bouLED/bouled/README.md

# bouLED

For more information, head over to [the blog](https://rose.telecom-paristech.fr/2019/bouled)
and to [hackaday.io](https://hackaday.io/project/168026-bouled).

The 3D design is made with OpenSCAD and SolveSpace. However, for PCB design,
Xpedition PCB was used (but PDF renders are available).

# License

This project, except the docs/ folder, is under the [GPLv3 license](LICENSE.md).

Copyright (c) 2018 Lucas Lebailly, Hichem Ghandri, Matthias Rabault
