bouLED/bouled/design/LED_Panel/README.md

The mounting holes are placed on the triangle's medians, the height of the lowest two being arbitrarily set to y=12mm.
See place_holes.py.
