bouLED/bouled/3dstructure/corner/README.md

# Corners

`corner.slvs` is a piece that links five triangles at their common corner. It's
made using `corner_element.slvs`, which is one fifth of the corner.

Only `corner.slvs` is meant to be 3D printed. These were made using SolveSpace
2.3.
