bouLED/bouled/3dstructure/prototype_triangle/README.md

# Prototype triangles

These were early experiments in triangle design, made to fit commercially
available APA102 strips in them to learn how to control them.
