bouLED/bouled/firmwares/mainboard/README.md

# Main board

This is the main board's firmware.

# Running

`make startgdbserver` starts the J-Link GDB Server. Then, in another terminal, run
`make debug` to compile, open GDB and flash the board.

# TODO
SPI1 MOSI GPIO speed
