bouLED/bouled/design/LED_Panel/Integration/AugmentedPins.txt

------------------------------------------------------------------------
            Part/Reference             | Pin | Augmented Net Name
------------------------------------------------------------------------
