bouLED/bouled/design/main_board/routing_STM32H743VIT6.ods

Sheet: Feuille1
STM32H743VIT6 (LQFP100)
 |  |  |  |  | AF0 | AF1 | AF2 | AF3 | AF4 | AF5 | AF6 | AF7 | AF8 | AF9 | AF10 | AF11 | AF12 | AF13 | AF14 | AF15
Pin | Connection | Pin name | I / O | 5V | SYS | TIM1/2/16/17 / LPTIM1/ HRTIM1 | SAI1 / TIM3/4/5/12 / HRTIM1 | LPUART / TIM8 / LPTIM2/3/4/5 / HRTIM1 / DFSDM | I2C1/2/3/4 / USART1 / TIM15 / LPTIM2 / DFSDM / CEC | SPI1/2/3/4/5/6 / CEC | SPI2/3 / SAI1/3 / I2C4 / UART4 / DFSDM | SPI2/3/6 / USART1/2/3/6 / UART7 / SDMMC1 | SPI6 / SAI2/4 / UART4/5/8 / LPUART / SDMMC1 / SPDIFRX | SAI4 / FDCAN1/2/ TIM13/14 / QUADSPI / FMC / SDMMC2 / LCD / SPDIFRX | SAI2/4 / TIM8 / QUADSPI / SDMMC2 / OTG1_HS / OTG2_FS / LCD | I2C4 / UART7 / SWPMI1 / TIM1/8 / DFSDM / SDMMC2 / MDIOS / ETH | TIM1/8 / FMC / SDMMC1 / MDIOS / OTG1_FS / LCD | TIM1 / DCMI / LCD / COMP | UART5 / LCD | SYS | Additionnal functions
1 | ESP_SPI_SCK | PE2 | I/O | FT_h | TRACECLK |  | SAI1_CK1 |  |  | SPI4_SCK | SAI1_MCLK_A |  | SAI4_MCLK_A | QUADSPI_BK1_IO2 | SAI4_CK1 | ETH_MII_TXD3 | FMC_A23 |  |  | EVENT OUT
2 | ESP_SPI_HS | PE3 | IRQ | FT_h | TRACED0 |  |  |  | TIM15_BKIN |  | SAI1_SD_B |  | SAI4_SD_B |  |  |  | FMC_A19 |  |  | EVENT OUT
3 | ESP_SPI_NSS | PE4 | I/O | FT_h | TRACED1 |  | SAI1_D2 | DFSDM_DATIN3 | TIM15_CH1N | SPI4_NSS | SA1_FS_A |  | SAI4_FS_A |  | SAI4_D2 |  | FMC_A20 | DCMI_D4 | LCD_B0 | EVENT OUT
4 | ESP_SPI_MISO | PE5 | I/O | FT_h | TRACED2 |  | SAI1_CK2 | DFSDM_CKIN3 | TIM15_CH1 | SPI4_MISO | SAI1_SCK_A |  | SAI4_SCK_A |  | SAI4_CK2 |  | FMC_A21 | DCMI_D6 | LCD_G0 | EVENT OUT
5 | ESP_SPI_MOSI | PE6 | I/O | FT_h | TRACED3 | TIM1_BKIN2 | SAI1_D1 |  | TIM15_CH2 | SPI4_MOSI | SA1_SD_A |  | SAI4_SD_A | SAI4_D1 | SAI2_MCK_B | TIM2_BKIN2_COMP12 | FMC_A22 | DCMI_D7 | LCD_G1 | EVENT OUT
6 |  | VBAT | S | __
7 |  | PC13 | I/O | FT |  |  |  |  |  |  |  |  |  |  |  |  |  |  |  | EVENT OUT
8 |  | PC14 / OSC32_IN | I/O | FT |  |  |  |  |  |  |  |  |  |  |  |  |  |  |  | EVENT OUT
9 |  | PC15 / OSC32_OUT | I/O | FT |  |  |  |  |  |  |  |  |  |  |  |  |  |  |  | EVENT OUT
10 |  | VSS | S | __
11 |  | VDD | S | __
12 | OSC_IN | PH0 / OSC_IN | I/O | FT |  |  |  |  |  |  |  |  |  |  |  |  |  |  |  | EVENT OUT
13 | OSC_OUT | PH1 / OSC_OUT | I/O | FT |  |  |  |  |  |  |  |  |  |  |  |  |  |  |  | EVENT OUT
14 |  | NRST | I/O | RST
15 |  | PC0 | I/O | FT_a |  |  |  | DFSDM_CKIN0 |  |  | DFSDM_DATIN4 |  | SAI2_FS_B |  | OTG_HS_ULPI_STP |  | FMC_SDNWE |  | LCD_R5 | EVENT OUT
16 | SPI2_MOSI | PC1 | I/O | FT_ha | TRACED0 |  | SAI1_D1 | DFSDM_DATAIN0 | DFSDM_CKIN4 | SPI2_MOSI / I2S2_SDO | SAI1_SD_A |  | SAI4_SD_A | SDMMC2_CK | SAI4_D1 | ETH_MDC | MDIOS_MDC |  |  | EVENT OUT
17 |  | PC2_C | I/O | TT_a |  |  |  | DFSDM_CKIN1 |  | SPI2_MISO / I2S2_SDI | DFSDM_CKOUT |  |  |  | OTG_HS_ULPI_DIR | ETH_MII_TXD2 | FMC_SDNE0 |  |  | EVENT OUT
18 |  | PC3_C | I/O | TT_a |  |  |  | DFSDM_DATAIN1 |  | SPI2_MOSI / I2S2_SDO |  |  |  |  | OTG_HS_ULPI_NXT | ETH_MII_TX_CLK | FMC_SDCKE0 |  |  | EVENT OUT
19 |  | VSSA | S | __
20 |  | VREF+ | S | __
21 |  | VDDA | S | __
22 | STM_2_ESP | PA0 | I/O | FT_a |  | TIM2_CH1 / TIM2_ETR | TIM5_CH1 | TIM8_ETR | TIM15_BKIN |  |  | USART2_CTS | UART4_TX | SDMMC2_CMD | SAI2_SD_B | ETH_MII_CRS |  |  |  | EVENT OUT
23 | ESP_2_STM | PA1 | I/O | FT_ha |  | TIM2_CH2 | TIM5_CH2 | LPTIM4_OUT | TIM15_CH1N |  |  | USART2_RTS | UART4_RX | QUADSPI_BK1_IO3 | SAI2_MCK_B | ETH_MII_RX_CLK / ETH_RMII_REF_CLK |  |  | LCD_R2 | EVENT OUT
24 |  | PA2 | I/O | FT_a |  | TIM2_CH3 | TIM5_CH3 | LPTIM4_OUT | TIM15_CH1 |  |  | USART2_TX | SAI2_SCK_B |  |  | ETH_MDIO | MDIOS_MDIO |  | LCD_R1 | EVENT OUT
25 |  | PA3 | I/O | FT_ha |  | TIM2_CH4 | TIM5_CH4 | LPTIM5_OUT | TIM15_CH2 |  |  | USART2_RX |  | LCD_B2 | OTG_HS_ULPI_D0 | ETH_MII_COL |  |  | LCD_B5 | EVENT OUT
26 |  | VSS | S | __
27 |  | VDD | S | __
28 |  | PA4 | I/O | TT_a |  |  | TIM5_ETR |  |  | SPI1_NSS / IS21_WS | SPI3_NSS / I2S3_WS | USART2_CK | SPI6_NSS |  |  |  | OTG_HS_SOF | DCMI_HSYNC | LCD_VSYNC | EVENT OUT
29 | SPI1_SCK | PA5 | I/O | TT_ha |  | TIM2_CH1 / TIM2_ETR |  | TIM8_CH1N |  | SPI1_SCK / I2S1_CK |  |  | SPI6_SCK |  | OTG_HS_ULPI_CK |  |  |  | LCD_R4 | EVENT OUT
30 |  | PA6 | I/O | FT_a |  | TIM1_BKIN | TIM3_CH1 | TIM8_BKIN |  | SPI1_MISO / I2S1_SDI |  |  | SPI6_MISO | TIM13_CH1 | TIM8_BKIN_COMP12 | MDIOS_MDC | TIM1_BKIN_COMP12 | DCMI_PIXCLK | LCD_G2 | EVENT OUT
31 | SPI1_MOSI | PA7 | I/O | TT_a |  | TIM1_CH1N | TIM3_CH2 | TIM8_CH1N |  | SPI1_MOSI / I2S1_SDO |  |  | SPI6_MOSI | TIM14_CH1 |  | ETH_MII_RDX_DV /ETH_RMII_CRS_DV | FMC_SDNWE |  |  | EVENT OUT
32 |  | PC4 | I/O | TT_a |  |  |  | DFSDM_CKIN2 |  | I2S1_MCK |  |  |  | SPDIF_RX_IN2 |  | ETH_MII_RXD0 /ETH_RMII_RXD0 | FMC_SDNE0 |  |  | EVENT OUT
33 |  | PC5 | I/O | TT_a |  |  | SAI1_D3 | DFSDM_DATAIN2 |  |  |  |  |  | SPDIF_RX_IN3 | SAI4_D3 | ETH_MII_RXD1 /ETH_RMII_RXD0 | FMC_SDCKE0 | COMP1_OUT |  | EVENT OUT
34 |  | PB0 | I/O | FT_a |  | TIM1_CH2N | TIM3_CH3 | TIM8_CH2N |  |  | DFSDM1_CKOUT |  | UART4_CTS | LCD_R3 | OTG_HS_ULPI_D1 | ETH_MII_RXD2 |  |  | LCD_G1 | EVENT OUT
35 |  | PB1 | I/O | TT_u |  | TIM1_CH3N | TIM3_CH4 | TIM8_CH3N |  |  | DFSDM1_DATIN1 |  |  | LCD_R6 | OTG_HS_ULPI_D2 | ETH_MII_RXD3 |  |  | LCD_G0 | EVENT OUT
36 |  | PB2 | I/O | FT_ha |  |  | SAI1_D1 |  | DFSDM_CKIN |  | SAI1_SD_A | SPI3_MOSI /I2S3_SDO | SAI4_SDA | QUADSPI_CLK | SAI4_D1 |  |  |  |  | EVENT OUT
37 |  | PE7 | I/O | TT_ha |  | TIM1_ETR |  | DFSDM_DATIN2 |  |  |  | UART7_RX |  |  | QUADSPI_BK2_IO0 |  | FMC_D4 / FMC_DA4 |  |  | EVENT OUT
38 |  | PE8 | I/O | TT_ha |  | TIM1_CH1N |  | DFSDM_CKIN2 |  |  |  | UART7_TX |  |  | QUADSPI_BK2_IO1 |  | FMC_D5 / FMC_DA5 | COMP2_OUT |  | EVENT OUT
39 |  | PE9 | I/O | TT_ha |  | TIM1_CH1 |  | DFSDM_CKOUT |  |  |  | UART7_RTS |  |  | QUADSPI_BK2_IO2 |  | FMC_D6 / FMC_DA6 |  |  | EVENT OUT
40 |  | PE10 | I/O | FT_ha |  | TIM1_CH2N |  | DFSDM_DATIN4 |  |  |  | UART7_CTS |  |  | QUADSPI_BK2_IO3 |  | FMC_D7 / FMC_DA7 |  |  | EVENT OUT
41 |  | PE11 | I/O | FT_ha |  | TIM1_CH2 |  | DFSDM_CKIN4 |  | SPI4_NSS |  |  |  |  | SAI2_SD_B |  | FMC_D8 / FMC_DA8 |  | LCD_G3 | EVENT OUT
42 |  | PE12 | I/O | FT_h |  | TIM1_CH3N |  | DFSDM_DATIN5 |  | SPI4_SCK |  |  |  |  | SAI2_SCK_B |  | FMC_D9 / FMC_DA9 | COMP_1_OUT | LCD_B4 | EVENT OUT
43 |  | PE13 | I/O | FT_h |  | TIM1_CH3 |  | DFSDM_CKIN5 |  | SPI4_MISO |  |  |  |  | SAI2_FS_B |  | FMC_D10 / FMC_DA10 | COMP_2_OUT | LCD_DE | EVENT OUT
44 |  | PE14 | I/O | FT_h |  | TIM1_CH4 |  |  |  | SPI4_MOSI |  |  |  |  | SAI2_MCK_B |  | FMC_D11 / FMC_DA11 |  | LCD_CLK | EVENT OUT
45 |  | PE15 | I/O | FT_h |  | TIM1_BKIN |  |  |  | HDMI_TIM1_BKIN |  |  |  |  |  |  | FMC_D12 / FMC_DA12 | TIM1_BKIN_COMP12 | LCD_R7 | EVENT OUT
46 | SPI2_SCK | PB10 | I/O | FT_f |  | TIM2_CH3 | HRTIM_SCOUT | LPTIM2_IN1 | I2C2_SCL | SPI2_SCK / I2S2_CK | DFSDM1_DATIN7 | USART3_TX |  | QUADSPI_BK1_NCS | OTG_HS_ULPI_D3 | ETH_MII_RX_ER |  |  | LCD_G4 | EVENT OUT
47 |  | PB11 | I/O | FT_f |  | TIM2_CH4 | HRTIM_SCIN | LPTIM2_ETR | I2C2_SDA |  | DFSDMI_CKIN7 | USART3_RX |  |  | OTG_HS_ULPI_D4 | ETH_MII_TX_EN / ETH_RMII_TX_EN |  |  | LCD_G5 | EVENT OUT
48 |  | VCAP-1 | S | __
49 |  | VSS | S | __
50 |  | VDD | S | __
51 |  | PB12 | I/O | FT_u |  | TIM1_BKIN |  |  | I2C2_SMBA | SPI2_NSS / I2S2_WS | DFSDM1_DATIN1 | USART3_CK |  | FDCAN2_RX | OTG_HS_ULPI_D5 | ETH_MII_TXD0 / ETH_RMII_TXD0 | OTG_HS_ID | TIM1_BKIN_COMP12 | UART5_RX | EVENT OUT
52 |  | PB13 | I/O | FT_u |  | TIM1_CH1N |  | LPTIM2_OUT |  | SPI2_SCK / I2S2_SCK | DFSDM1_CKIN1 | USART3_CTS_NSS |  | FDCAN2_TX | OTG_HS_ULPI_D6 | ETH_MII_TXD1 / ETH_RMII_TXD1 |  |  | UART5_TX | EVENT OUT
53 | SDMMC2_D0 | PB14 | I/O | FT_u |  | TIM1_CH2N | TIM12_CH1 | TIM8_CH2N | USART1_TX | SPI2_MISO / I2S2_SDI | DFSDM1_DATIN2 | USART3_RTS | UART4_RTS | SDMMC2_D0 |  |  | OTG_HS_DM |  |  | EVENT OUT
54 |  | PB15 | I/O | FT_u | RTC_REFIN | TIM1_CH3N | TIM12_CH2 | TIM8_CH3N | USART1_RX | SPI2_MOSI / I2S2_SDO | DFSDM1_CKIN2 |  | UART4_CTS | SDMMC2_D1 |  |  | OTG_HS_DP |  |  | EVENT OUT
55 |  | PD8 | I/O | FT_h |  |  |  | DFSDM_CKIN3 |  |  | SAI3_SCK_B | USART3_TX |  | SPDIFRX_IN1 |  |  | FMC_D13 / FMC_DA13 |  |  | EVENT OUT
56 |  | PD9 | I/O | FT_h |  |  |  | DFSDM_DATAIN3 |  |  | SAI3_SD_B | USART3_RX |  | FDCAN2_RXFD_MODE |  |  | FMC_D14 / FMC_DA14 |  |  | EVENT OUT
57 |  | PD10 | I/O | FT_h |  |  |  | DFSDM_CKOUT |  |  | SAI3_FS_B | USART3_CK |  | FDCAN2_TXFD_MODE |  |  | FMC_D15 / FMC_DA15 |  | LCD_B3 | EVENT OUT
58 |  | PD11 | I/O | FT_h |  |  |  | LPTIM2_IN2 | I2C4_SMBA |  |  | USART3_CTS |  | QUADSPI_BK1_IO0 | SAI2_SD_A |  | FMC_A16 |  |  | EVENT OUT
59 | I2C_SCL | PD12 | I/O | FT_fh |  | LPTIM1_IN1 | TIM4_CH1 | LPTIM2_IN1 | I2C4_SCL |  |  | USART3_RTS |  | QUADSPI_BK1_IO1 | SAI2_FS_A |  | FMC_A17 |  |  | EVENT OUT
60 | I2C_SDA | PD13 | I/O | FT_fh |  | LPTIM1_OUT | TIM4_CH2 |  | I2C4_SDA |  |  |  |  | QUADSPI_BK1_IO3 | SAI2_SCK_A |  | FMC_A18 |  |  | EVENT OUT
61 |  | PD14 | I/O | FT_h |  |  | TIM4_CH3 |  |  |  | SAI3_MCLK_B |  | UART8_CTS |  |  |  | FMC_D0 / FMC_DA0 |  |  | EVENT OUT
62 |  | PD15 | I/O | FT_h |  |  | TIM4_CH4 |  |  |  | SAI3_MCLK_A |  | UART8_RTS |  |  |  | FMC_D1 / FMC_DA1 |  |  | EVENT OUT
63 |  | PC6 | I/O | FT_h |  | HRTIM_CHA1 | TIM3_CH1 | TIM8_CH1 | DFSDM_CKIN3 | I2S2_MCK |  | USART6_TX | SDMMC1_D0DIR | FMC_NWAIT | SDMMC2_D6 |  | SDMMC1_D6 | DCMI_D0 | LCD_HSYNC | EVENT OUT
64 |  | PC7 | I/O | FT_h | TRGIO | HRTIM_CHA2 | TIM3_CH2 | TIM8_CH2 | DFSDM_DATIN3 |  | I2S3_MCK | USART6_RX | SDMMC1_D123DIR | FMC_NE1 | SDMMC2_D7 | SWPMI_TX | SDMMC1_D7 | DCMI_D1 | LCD_G6 | EVENT OUT
65 |  | PC8 | I/O | FT_h | TRACED1 | HRTIM_CHB1 | TIM3_CH3 | TIM8_CH3 |  |  |  | USART6_CK | UART5_RTS | FMC_NE2 / FMC_NCE |  | SWPMI_RX | SDMMC1_D0 | DCMI_D2 |  | EVENT OUT
66 |  | PC9 | I/O | FT_fh | MCO2 |  | TIM3_CH4 | TIM8_CH4 | I2C3_SDA | I2S_CKIN |  |  | UART5_CTS | QUADSPI_BK1_IO0 | LCD_G3 | SWPMI_SUSPEND | SDMMC1_D1 | DCMI_D3 | LCD_B2 | EVENT OUT
67 | LED_R | PA8 | I/O | FT_fha | MCO1 | TIM1_CH1 | HRTIM_CHB2 | TIM8_BKIN2 | I2C3_SCL |  |  | USART1_CK |  |  | OTG_FS_SOF | UART7_RX | TIM8_BKIN2_COMP12 | LCD_B3 | LCD_R6 | EVENT OUT
68 | LED_G | PA9 | I/O | FT_u |  | TIM1_CH2 | HRTIM_CHC1 | LPUART1_TX | I2C3_SMBA | SPI2_SCK / I2S2_CK |  | USART1_TX |  | FDCAN1_RXFD_MODE |  |  |  | DCMI_D0 | LCD_R5 | EVENT OUT
69 | LED_B | PA10 | I/O | FT_u |  | TIM1_CH3 | HRTIM_CHC2 | LPUART1_RX |  |  |  | USART1_RX |  | FDCAN1_TXFD_MODE | OTG_FS_ID | MDIOS_MDIO | LCD_B4 | DCMI_D1 | LCD_B1 | EVENT OUT
70 |  | PA11 | I/O | FT_u |  | TIM1_CH4 | HRTIM_CHD1 | LPUART1_CTS |  | SPI2_NSS / I2S2_WS | UART4_RX | USART1_CTS |  | FDCAN1_RX | OTG_FS_DM |  |  |  | LCD_R4 | EVENT OUT
71 |  | PA12 | I/O | FT_u |  | TIM1_ETR | HRTIM_CHD2 | LPUART1_RTS |  | SPI2_SCK / I2S2_CK | UART4_TX | USART1_RTS | SAI2_FS_B | FDCAN1_TX | OTG_FS_DP |  |  |  | LCD_R5 | EVENT OUT
72 | JTMS-SWDIO | PA13 / JTMS-SWDIO | I/O | FT | JTMS-SWDIO |  |  |  |  |  |  |  |  |  |  |  |  |  |  | EVENT OUT
73 |  | VCAP-2 | S | __
74 |  | VSS | S | __
75 |  | VDD | S | __
76 | JTCK-SWCLK | PA14 / JTCK-SWCLK | I/O | FT | JTCK-SWCLK |  |  |  |  |  |  |  |  |  |  |  |  |  |  | EVENT OUT
77 |  | PA15 / JTDI | I/O | FT | JTDI | TIM2_CH1 / TIM2_ETR | HRTIM_FLT1 |  | HDMI_CEC | SPI1_NSS / I2S1_WS | SPI3_NSS / I2S3_WS | SPI6_NSS | UART4_RTS |  |  | UART7_TX |  |  |  | EVENT OUT
78 | SPI3_SCK | PC10 | I/O | FT_ha |  |  | HRTIM_EEV1 | DFSDM_CKIN5 |  |  | SPI3_SCK / I2S3_CK | USART3_TX | UART4_TX | QUADSPI_BK1_IO1 |  |  | SDMMC1_D2 | DCMI_D8 | LCD_R2 | EVENT OUT
79 |  | PC11 | I/O | FT_h |  |  | HRTIM_FLT2 | DFSDM_DATAIN5 |  |  | SPI3_MISO / I2S3_SDI | USART3_RX | UART4_RX | QUADSPI_BK2_NCS |  |  | SDMMC1_D3 | DCMI_D4 |  | EVENT OUT
80 | SPI3_MOSI | PC12 | I/O | FT_h | TRACED3 |  | HRTIM_EEV2 |  |  |  | SPI3_MOSI / I2S3_SDO | USART3_CK | UART5_TX |  |  |  | SDMMC1_CK | DCMI_D9 |  | EVENT OUT
81 |  | PD0 | I/O | FT_h |  |  |  | DFSDM_CKIN6 |  |  | SAI3_SCK_A |  | UART4_RX | FDCAN1_RX |  |  | FMC_D2 / FMC_DA2 |  |  | EVENT OUT
82 |  | PD1 | I/O | FT_h |  |  |  | DFSDM_DATAIN6 |  |  | SAI3_SD_A |  | UART4_TX | FDCAN1_TX |  |  | FMC_D3 / FMC_DA3 |  |  | EVENT OUT
83 |  | PD2 | I/O | FT_h | TRACED2 |  | TIM3_ETR |  |  |  |  |  | UART5_RX |  |  |  | SDMMC1_CMD | DCMI_D11 |  | EVENT OUT
84 |  | PD3 | I/O | FT_h |  |  |  | DFSDM_CKOUT |  | SPI2_SCK / I2S2_CK |  | USART2_CTS |  |  |  |  | FMC_CLK | DCMI_D5 | LCD_G7 | EVENT OUT
85 |  | PD4 | I/O | FT_h |  |  | HRTIM_FLT3 |  |  |  | SAI3_FS_A | USART2_RTS |  | FDCAN1_RXFD_MODE |  |  | FMC_NOE |  |  | EVENT OUT
86 |  | PD5 | I/O | FT_h |  |  | HRTIM_EEV3 |  |  |  |  | USART2_TX |  | FDCAN1_TXFD_MODE |  |  | FMC_NWE |  |  | EVENT OUT
87 | SDMMC2_CK | PD6 | I/O | FT_h |  |  | SAI1_D1 | DFSDM_CKIN4 | DFSDM_DATIN1 | SPI3_MOSI / I2S3_SDO | SAI1_SD_A | USART2_RX | SAI4_SD_A | FDCAN2_RXFD_MODE | SAI4_D1 | SDMMC2_CK | FMC_NWAIT | DCMI_D10 | LCD_B2 | EVENT OUT
88 | SDMMC2_CMD | PD7 | I/O | FT_h |  |  |  | DFSDM_DATAIN4 |  | SPI1_MOSI / I2S1_SDO | DFSDM1_CKIN1 | USART2_CK |  | SPDIFRX_IN0 |  | SDMMC2_CMD | FMC_NE1 |  |  | EVENT OUT
89 | SPI6_SCK | PB3 / JTDO / TRASCESWO | I/O | FT | JTDOTRACESWO | TIM2_CH2 | HRTIM_FLT4 |  |  | SPI1_SCK / I2S1_CK | SPI3_SCK / I2S3_CK |  | SPI6_SCK | SDMMC2_D2 |  | UART7_RX |  |  |  | EVENT OUT
90 |  | PB4 / NJTRST | I/O | FT | NJTRST | TIM16_BKIN | TIM3_CH1 | HRTIM_EEV6 |  | SPI1_MISO / I2S1_SDI | SPI3_MISO / I2S3_SDI | SPI2_NSS / I2S2_WS | SPI6_MISO | SDMMC2_D3 |  | UART7_TX |  |  |  | EVENT OUT
91 | SPI6_MOSI | PB5 | I/O | FT |  | TIM17_BKIN | TIM3_CH2 | HRTIM_EEV7 | I2C1_SMBA | SPI1_MOSI / I2S1_SDO | I2C4_SMBA | SPI3_MOSI /I2S3_SDO | SPI6_MOSI | FDCAN2_RX | OTG_HS_ULPI_D7 | ETH_PPS_OUT | FMC_SDCKE1 | DCMI_D10 | UART5_RX | EVENT OUT
92 |  | PB6 | I/O | FT_f |  | TIM16_CH1N | TIM4_CH1 | HRTIM_EEV8 | I2C1_SCL | HDMI_CEC | I2C4_SCL | USART1_TX | LPUART1_TX | FDCAN2_TX | QUADSPI_BK1_NCS | DFSDM_DATIN5 | FMC_SDNE1 | DCMI_D5 | UART5_TX | EVENT OUT
93 |  | PB7 | I/O | FT_fa |  | TIM17_CH1N | TIM4_CH2 | HRTIM_EEV9 | I2C1_SDA |  | I2C4_SDA | USART1_RX | LPUART1_RX | FDCAN2_TXFD_MODE |  | DFSDM_CKIN5 | FMC_NL | DCMI_VSYNC
94 |  | BOOT0 | I | B |  |  |  |  |  |  |  |  |  |  |  |  |  |  |  |  | VPP
95 |  | PB8 | I/O | FT_fh |  | TIM16_CH1 | TIM4_CH3 | DFSDM_CKIN7 | I2C1_SCL |  | I2C4_SCL | SDMMC1_CKIN | UART4_RX | FDCAN1_RX | SDMCC2_D4 | ETH_MII_TXD3 | SDMMC1_D4 | DCMI_D6 | LCD_B6 | EVENT OUT
96 |  | PB9 | I/O | FT_fh |  | TIM17_CH1 | TIM4_CH4 | DFSDM_DATIN7 | I2C1_SDA | SPI2_NSS / I2S2_WS | I2C4_SDA | SDMMC1_CDIR | UART4_TX | FDCAN1_TX | SDMCC2_D5 | I2C4_SMBA | SDMCC1_D5 | DCMI_D7 | LCD_B7 | EVENT OUT
97 |  | PE0 | I/O | FT_h |  | LPTIM1_ETR | TIM4_ETR | HRTIM_SCIN | LPTIM2_ETR |  |  |  | UART8_RX | FDCAN1_RXFD_MODE | SAI2_MCK_A |  | FMC_NBL0 | DCMI_D2 |  | EVENT OUT
98 |  | PE1 | I/O | FT_h |  | LPTIM1_IN2 |  | HRTIM_SCOUT |  |  |  |  | UART8_TX | FDCAN1_TXFD_MODE |  |  | FMC_NBL1 | DCMI_D3 |  | EVENT OUT
99 |  | VSS | S | __
100 |  | VDD | S | __

Sheet: Feuille2
Pin | Connection | Pin name | I / O | 5V | SYS | TIM1/2/16/17 / LPTIM1/ HRTIM1 | SAI1 / TIM3/4/5/12 / HRTIM1 | LPUART / TIM8 / LPTIM2/3/4/5 / HRTIM1 / DFSDM | I2C1/2/3/4 / USART1 / TIM15 / LPTIM2 / DFSDM / CEC | SPI1/2/3/4/5/6 / CEC | SPI2/3 / SAI1/3 / I2C4 / UART4 / DFSDM | SPI2/3/6 / USART1/2/3/6 / UART7 / SDMMC1 | SPI6 / SAI2/4 / UART4/5/8 / LPUART / SDMMC1 / SPDIFRX | SAI4 / FDCAN1/2/ TIM13/14 / QUADSPI / FMC / SDMMC2 / LCD / SPDIFRX | SAI2/4 / TIM8 / QUADSPI / SDMMC2 / OTG1_HS / OTG2_FS / LCD | I2C4 / UART7 / SWPMI1 / TIM1/8 / DFSDM / SDMMC2 / MDIOS / ETH | TIM1/8 / FMC / SDMMC1 / MDIOS / OTG1_FS / LCD | TIM1 / DCMI / LCD / COMP | UART5 / LCD | SYS | Additionnal functions
1 |  | PE2 | O | FT | TRACECLK |  |  |  |  | SPI4_SCK | SAI1_MCLK_A |  |  | QUADSPI_BK1_IO2 |  | ETH_MII_TXD3 | FMC_A23 |  |  | EVENT OUT
2 |  | PE3 | O | FT | TRACED0 |  |  |  |  |  | SAI1_SD_B |  |  |  |  |  | FMC_A19 |  |  | EVENT OUT
3 |  | PE4 | O | FT | TRACED1 |  |  |  |  | SPI4_NSS | SA1_FS_A |  |  |  | DFSDM1_DATAIN3 |  | FMC_A20 | DCMI_D4 | LCD_B0 | EVENT OUT
4 |  | PE5 | I | FT | TRACED2 |  |  | TIM9_CH1 |  | SPI4_MISO | SAI1_SCK_A |  |  |  | DFSDM1_CKIN3 |  | FMC_A21 | DCMI_D6 | LCD_G0 | EVENT OUT
5 |  | PE6 | O | FT | TRACED3 | TIM1_BKIN2 |  | TIM9_CH2 |  | SPI4_MOSI | SA1_SD_A |  |  |  | SAI2_MCK_B |  | FMC_A22 | DCMI_D7 | LCD_G1 | EVENT OUT
6 |  | VBAT | S | __
7 |  | PC13 | O | FT |  |  |  |  |  |  |  |  |  |  |  |  |  |  |  | EVENT OUT | RTC_TAMP1/ RTC_TS/ RTC_OUT/ WKUP4
8 |  | PC14 / OSC32_IN | O | FT |  |  |  |  |  |  |  |  |  |  |  |  |  |  |  | EVENT OUT | OSC32_IN
9 |  | PC15 / OSC32_OUT | O | FT |  |  |  |  |  |  |  |  |  |  |  |  |  |  |  | EVENT OUT | OSC32_OUT
10 |  | VSS | S | __
11 |  | VDD | S | __
12 |  | PH0 / OSC_IN | A | FT |  |  |  |  |  |  |  |  |  |  |  |  |  |  |  | EVENT OUT | OSC_IN
13 |  | PH1 / OSC_OUT | A | FT |  |  |  |  |  |  |  |  |  |  |  |  |  |  |  | EVENT OUT | OSC_OUT
14 |  | NRST | I/O | RST
15 |  | PC0 | O | FT |  |  |  | DFSDM1_CKIN0 |  |  | DFSDM1_DATIN4 |  | SAI2_FS_B |  | OTG_HS_ULPI_STP |  | FMC_SDNWE |  | LCD_R5 | EVENT OUT | ADC1_IN10, ADC2_IN10, ADC3_IN10
16 |  | PC1 | O | FT | TRACED0 |  |  | DFSDM1_DATAIN0 |  | SPI2_MOSI / I2S2_SD | SAI1_SD_A |  |  |  | DFSDM1_CKIN4 | ETH_MDC | MDIOS_MDC |  |  | EVENT OUT | ADC1_IN11, ADC2_IN11, ADC3_IN11, RTC_TAMP3/ WKUP3
17 |  | PC2_C | O | FT |  |  |  | DFSDM1_CKIN1 |  | SPI2_MISO | DFSDM1_CKOUT |  |  |  | OTG_HS_ULPI_DIR | ETH_MII_TXD2 | FMC_SDNE0 |  |  | EVENT OUT | ADC1_IN12, ADC2_IN12, ADC3_IN12
18 |  | PC3_C | O | FT |  |  |  | DFSDM1_DATAIN1 |  | SPI2_MOSI / I2S2_SD |  |  |  |  | OTG_HS_ULPI_NXT | ETH_MII_TX_CLK | FMC_SDCKE0 |  |  | EVENT OUT | ADC1_IN13, ADC2_IN13, ADC3_IN13
19 |  | VSSA | S | __
20 |  | VREF+ | S | __
21 |  | VDDA | S | __
22 |  | PA0 | IO | FT |  | TIM2_CH1 / TIM2_ETR | TIM5_CH1 | TIM8_ETR | ITIM15_BKIN |  |  | USART2_CTS | UART4_TX | SDMMC2_CMD | SAI2_SD_B | ETH_MII_CRS |  |  |  | EVENT OUT | ADC1_IN0, ADC2_IN0, ADC3_IN0, WKUP1
23 |  | PA1 | I | FT |  | TIM2_CH2 | TIM5_CH2 | LPTIM4_OUT |  |  |  | USART2_RTS | UART4_RX | QUADSPI_BK1_IO3 | SAI2_MCK_B | ETH_MII_RX_CLK / ETH_RMII_REF_CLK |  |  | LCD_R2 | EVENT OUT | ADC1_IN1, ADC2_IN1, ADC3_IN1
24 |  | PA2 | I/O | FT |  | TIM2_CH3 | TIM5_CH3 | TIM9_CH1 |  |  |  | USART2_TX | SAI2_SCK_B |  |  | ETH_MDIO | MDIOS_MDIO |  | LCD_R1 | EVENT OUT | ADC1_IN2, ADC2_IN2, ADC3_IN2, WKUP2
25 |  | PA3 | A | FT |  | TIM2_CH4 | TIM5_CH4 | TIM9_CH2 |  |  |  | USART2_RX |  | LCD_B2 | OTG_HS_ULPI_D0 | ETH_MII_COL |  |  | LCD_B5 | EVENT OUT | ADC1_IN12, ADC2_IN12, ADC3_IN12
26 |  | VSS | S | __
27 |  | VDD | S | __
28 |  | PA4 | OA | Tta |  |  |  |  |  | SPI1_NSS / IS21_WS | SPI3_NSSI / I2S3_WS | USART2_CK | SPI6_NSS |  |  |  | OTG_HS_SOF | DCMI_HSYNC | LCD_VSYNC | EVENT OUT | ADC1_IN4, ADC2_IN4, DAC_OUT1
29 |  | PA5 | OA | Tta |  | TIM2_CH1 / TIM2_ETR |  | TIM8_CH1N |  | SPI1_SCK / I2S1_CK |  |  | SPI6_SCK |  | OTG_HS_ULPI_CK |  |  |  | LCD_R4 | EVENT OUT | ADC1_IN5, ADC2_IN5, DAC_OUT2
30 |  | PA6 | I/O | FT |  | TIM1_BKIN | TIM3_CH1 | TIM8_BKIN |  | SPI1_MISO |  |  | SPI6_MISO | TIM13_CH1 |  |  | MDIOS_MDC | DCMI_PIXCLK | LCD_G2 | EVENT OUT | ADC1_IN6, ADC2_IN6
31 |  | PA7 | I | FT |  | TIM1_CH1N | TIM3_CH2 | TIM8_CH1N |  | SPI1_MOSI / I2S1_SD |  |  | SPI6_MOSI | TIM14_CH1 |  | ETH_MII_RDX_DV /ETH_RMII_CRS_DV | FMC_SDNWE |  |  | EVENT OUT | ADC1_IN7, ADC2_IN7
32 |  | PC4 | I | FT |  |  |  | DFSDM1_CKIN2 |  | I2S1_MCK |  |  | SPIDIF_RX2 |  |  | ETH_MII_RXD0 /ETH_RMII_RXD0 | FMC_SDNE0 |  |  | EVENT OUT | ADC1_IN14, ADC2_IN14
33 |  | PC5 | I | FT |  |  |  | DFSDM1_DATAIN2 |  |  |  |  | SPDIF_RX3 |  |  | ETH_MII_RXD1 /ETH_RMII_RXD0 | FMC_SDCKE0 |  |  | EVENT OUT | ADC1_IN15, ADC2_IN15
34 |  | PB0 | I/O | FT |  | TIM1_CH2N | TIM3_CH3 | TIM8_CH2N |  |  | DFSDM1_CKOUT |  | UART4_CTS | LCD_R3 | OTG_HS_ULPI_D1 | ETH_MII_RXD2 |  |  | LCD_G1 | EVENT OUT | ADC1_IN8, ADC2_IN8
35 |  | PB1 | A | FT |  | TIM1_CH3N | TIM3_CH4 | TIM8_CH3N |  |  | DFSDM1_DATIN1 |  |  | LCD_R6 | OTG_HS_ULPI_D2 | ETH_MII_RXD3 |  |  | LCD_G0 | EVENT OUT | ADC1_IN9, ADC2_IN9
36 |  | PB2 | I/O | FT |  |  |  |  |  |  | SAI1_SD_A | SPI3_MOSI /I2S3_SD |  | QUADSPI_CLK | DFSDM1_CKIN1 |  |  |  |  | EVENT OUT
37 |  | PE7 | I/O | FT |  | TIM1_ETR |  |  |  |  | DFSDM1_DATAIN2 |  | UART7_RX |  | QUADSPI_BK2_IO0 |  | FMC_D4 |  |  | EVENT OUT
38 |  | PE8 | I/O | FT |  | TIM1_CH1N |  |  |  |  | DFSDM1_CKIN2 |  | UART7_TX |  | QUADSPI_BK2_IO1 |  | FMC_D5 |  |  | EVENT OUT
39 |  | PE9 | I/O | FT |  | TIM1_CH1 |  |  |  |  | DFSDM1_CKOUT |  | UART7_RTS |  | QUADSPI_BK2_IO2 |  | FMC_D6 |  |  | EVENT OUT
40 |  | PE10 | I/O | FT |  | TIM1_CH2N |  |  |  |  | DFSDM1_DATAIN4 |  | UART7_CTS |  | QUADSPI_BK2_IO3 |  | FMC_D7 |  |  | EVENT OUT
41 |  | PE11 | O | FT |  | TIM1_CH2 |  |  |  | SPI4_NSS | DFSDM1_CKIN4 |  |  |  | SAI2_SD_B |  | FMC_D8 |  | LCD_G3 | EVENT OUT
42 |  | PE12 | I/O | FT |  | TIM1_CH3N |  |  |  | SPI4_SCK | DFSDM1_DATAIN5 |  |  |  | SAI2_SCK_B |  | FMC_D9 |  | LCD_B4 | EVENT OUT
43 |  | PE13 | I/O | FT |  | TIM1_CH3 |  |  |  | SPI4_MISO | DFSDM1_CKIN5 |  |  |  | SAI2_FS_B |  | FMC_D10 |  | LCD_DE | EVENT OUT
44 |  | PE14 | O | FT |  | TIM1_CH4 |  |  |  | SPI4_MOSI |  |  |  |  | SAI2_MCK_B |  | FMC_D11 |  | LCD_CLK | EVENT OUT
45 |  | PE15 | I/O | FT |  | TIM1_BKIN |  |  |  |  |  |  |  |  |  |  | FMC_D10 |  | LCD_R7 | EVENT OUT
46 |  | PB10 | I/O | FT |  | TIM2_CH3 |  |  | I2C2_SCL | SPI2_SCK / I2S2_CK | DFSDM1_DATIN7 | USART3_TX |  | QUADSPI_BK1_NCS | OTG_HS_ULPI_D3 | ETH_MII_RX_ER |  |  | LCD_G4 | EVENT OUT
47 |  | PB11 | O | FT |  | TIM2_CH4 |  |  | I2C2_SDA |  | DFSDMI_CKIN7 | USART3_RX |  |  | OTG_HS_ULPI_D4 | ETH_MII_TX_EN / ETH_RMII_TX_EN |  | DSI_TE | LCD_G5 | EVENT OUT
48 |  | VCAP-1 | S | __
49 |  | VSS | S | __
50 |  | VDD | S | __
51 |  | PB12 | O | FT |  | TIM1_BKIN |  |  | I2C2_SMBA | SPI2_NSS / I2S2_WS | DFSDM1_DATIN1 | USART3_CK | UART5_RX | CAN2_RX | OTG_HS_ULPI_D5 | ETH_MII_TXD0 / ETH_RMII_TXD0 | OTG_HS_ID |  |  | EVENT OUT
52 |  | PB13 | O | FT |  | TIM1_CH1N |  |  |  | SPI2_SCK / I2S2_SCK | DFSDM1_CKIN1 | USART3_CTS | UART5_TX | CAN2_TX | OTG_HS_ULPI_D6 | ETH_MII_TXD1 / ETH_RMII_TXD1 |  |  |  | EVENT OUT | OTG_HS_VBUS
53 |  | PB14 | I/O | FT |  | TIM1_CH2N |  | TIM8_CH2N | USART1_TX | SPI2_MISO | DFSDM1_DATIN2 | USART3_RTS | UART4_RTS | TIM12_CH1 | SDMMC2_D0 |  | OTG_HS_DM |  |  | EVENT OUT
54 |  | PB15 | I/O | FT | RTC_REFIN | TIM1_CH3N |  | TIM8_CH3N | USART1_RX | SPI2_MOSI / I2S2_SD | DFSDM1_CKIN2 |  | UART4_CTS | TIM12_CH2 | SDMMC2_D1 |  | OTG_HS_DP |  |  | EVENT OUT
55 |  | PD8 | I/O | FT |  |  |  | DFSDM1_CKIN3 |  |  |  | USART3_TX | SPDIF_RX1 |  |  |  | FMC_D13 |  |  | EVENT OUT
56 |  | PD9 | I/O | FT |  |  |  | DFSDM1_DATAIN3 |  |  |  | USART3_RX |  |  |  |  | FMC_D14 |  |  | EVENT OUT
57 |  | PD10 | I/O | FT |  |  |  | DFSDM1_CKOUT |  |  |  | USART3_CK |  |  |  |  | FMC_D15 |  | LCD_B3 | EVENT OUT
58 |  | PD11 | I/O | FT |  |  |  |  | I2C4_SMBA |  |  | USART3_CTS |  | QUADSPI_BK1_IO0 | SAI2_SD_A |  | FMC_A16FMC_CLE |  |  | EVENT OUT
59 |  | PD12 | I | FT |  |  | TIM4_CH1 | LPTIM1_IN1 | I2C4_SCL |  |  | USART3_RTS |  | QUADSPI_BK1_IO1 | SAI2_FS_A |  | FMC_A17FMC_ALE |  |  | EVENT OUT
60 |  | PD13 | O | FT |  |  | TIM4_CH2 | LPTIM1_OUT | I2C4_SDA |  |  |  |  | QUADSPI_BK1_IO3 | SAI2_SCK_A |  | FMC_A18 |  |  | EVENT OUT
61 |  | PD14 | O | FT |  |  | TIM4_CH3 |  |  |  |  |  | UART8_CTS |  |  |  | FMC_D0 |  |  | EVENT OUT
62 |  | PD15 | O | FT |  |  | TIM4_CH4 |  |  |  |  |  | UART8_RTS |  |  |  | FMC_D1 |  |  | EVENT OUT
63 |  | PC6 | O | FT |  |  | TIM3_CH1 | TIM8_CH1 |  | I2S2_MCK |  | DFSDM1_CKIN3 | USART6_TX | FMC_NWAIT | SDMMC2_D6 |  | SDMMC_D6 | DCMI_D0 | LCD_HSYNC | EVENT OUT
64 |  | PC7 | I | FT |  |  | TIM3_CH2 | TIM8_CH2 |  |  | I2S3_MCK | DFSDM1_DATAIN3 | USART6_RX | FMC_NE1 | SDMMC2_D7 |  | SDMMC_D7 | DCMI_D1 | LCD_G6 | EVENT OUT
65 |  | PC8 | I/O | FT | TRACED1 |  | TIM3_CH3 | TIM8_CH3 |  |  |  | UART5_RTS | USART6_CK | FMC_NE2FMC_NCE |  |  | SDMMC_D0 | DCMI_D2 |  | EVENT OUT
66 |  | PC9 | I/O | FT | MCO2 |  | TIM3_CH4 | TIM8_CH4 | I2C3_SDA | I2S_CKIN |  | UART5_CTS |  | QUADSPI_BK1_IO0 | LCD_G3 |  | SDMMC_D1 | DCMI_D3 | LCD_B2 | EVENT OUT
67 |  | PA8 | I | FT | MCO1 | TIM1_CH1 |  | TIM8_BKIN2 | I2C3_SCL |  |  | USART1_SCK |  |  | OTG_FS_SOF | CAN3_RX | UART7_RX | LCD_B3 | LCD_R6 | EVENT OUT
68 |  | PA9 | I | FT |  | TIM1_CH2 |  |  | I2C3_SMBA | SPI2_SCK / I2S2_CK |  | USART1_TX |  |  |  |  |  | DCMI_D0 | LCD_R5 | EVENT OUT | OTG_FS_VB US
69 |  | PA10 | I | FT |  | TIM1_CH3 |  |  |  |  |  | USART1_RX |  | LCD_B4 | OTG_FS_ID |  | MDIOS_MDIO | DCMI_D1 | LCD_B1 | EVENT OUT
70 |  | PA11 | I/O | FT |  | TIM1_CH4 |  |  |  | SPI2_NSS / I2S2_WS | UART4_RX | USART1_CTS |  | CAN1_RX | OTG_FS_DM |  |  |  | LCD_R4 | EVENT OUT
71 |  | PA12 | I/O | FT |  | TIM1_ETR |  |  |  | SPI2_SCK / I2S2_CK | UART4_TX | USART1_RTS | SAI2_FS_B | CAN1_TX | OTG_FS_DP |  |  |  | LCD_R5 | EVENT OUT
72 |  | PA13 / JTMS-SWDIO | I/O | FT | JTMS-SWDIO |  |  |  |  |  |  |  |  |  |  |  |  |  |  | EVENT OUT
73 |  | VCAP-2 | S | __
74 |  | VSS | S | __
75 |  | VDD | S | __
76 |  | PA14 / JTCK-SWCLK | I/O | FT | JTCK-SWCLK |  |  |  |  |  |  |  |  |  |  |  |  |  |  | EVENT OUT
77 |  | PA15 / JTDI | I/O | FT | JTDI | TIM2_CH1 / TIM2_ETR |  |  | HDMI_CEC | SPI1_NSS / I2S1_WS | SPI3_NSS / I2S3_WS | SPI6_NSS | UART4_RTS |  |  | CAN3_TX | UART7_TX |  |  | EVENT OUT
78 |  | PC10 | I/O | FT |  |  |  | DFSDM1_CKIN5 |  |  | SPI3_SCK / I2S3_CK | USART3_TX | UART4_TX | QUADSPI_BK1_IO1 |  |  | SDMMC_D2 | DCMI_D8 | LCD_R2 | EVENT OUT
79 |  | PC11 | I/O | FT |  |  |  | DFSDM1_DATAIN5 |  |  | SPI3_MISO | USART3_RX | UART4_RX | QUADSPI_BK2_NCS |  |  | SDMMC_D3 | DCMI_D4 |  | EVENT OUT
80 |  | PC12 | O | FT | TRACED3 |  |  |  |  |  | SPI3_MOSI / I2S3_SD | USART3_CK | UART5_TX |  |  |  | SDMMC_CK | DCMI_D9 |  | EVENT OUT
81 |  | PD0 | I | FT |  |  |  | DFSDM1_CKIN6 |  |  | DFSDM1_DATAIN7 |  | UART4_RX | CAN1_RX |  |  | FMC_D2 |  |  | EVENT OUT
82 |  | PD1 | I | FT |  |  |  | DFSDM1_DATAIN6 |  |  | DFSDM1_CKIN7 |  | UART4_TX | CAN1_TX |  |  | FMC_D3 |  |  | EVENT OUT
83 |  | PD2 | O | FT | TRACED2 |  | TIM3_ETR |  |  |  |  |  | UART5_RX |  |  |  | SDMMC_CMD | DCMI_D11 |  | EVENT OUT
84 |  | PD3 | O | FT |  |  |  | DFSDM1_CKOUT |  | SPI2_SCK / I2S2_CK | DFSDM1_DATAIN0 | USART2_CTS |  |  |  |  | FMC_CLK | DCMI_D5 | LCD_G7 | EVENT OUT
85 |  | PD4 | O | FT |  |  |  |  |  |  | DFSDM1_CKIN0 | USART2_RTS |  |  |  |  | FMC_NOE |  |  | EVENT OUT
86 |  | PD5 | O | FT |  |  |  |  |  |  |  | USART2_TX |  |  |  |  | FMC_NWE |  |  | EVENT OUT
87 |  | PD6 | O | FT |  |  |  | DFSDM1_CKIN4 |  | SPI3_MOSI / I2S3_SD | SAI1_SD_A | USART2_RX |  |  | DFSDM1_DATAIN1 | SDMMC2_CK | FMC_NWAIT | DCMI_D10 | LCD_B2 | EVENT OUT
88 |  | PD7 | O | FT |  |  |  | DFSDM1_DATAIN4 |  | SPI1_MOSI / I2S1_SD | DFSDM1_CKIN1 | USART2_CK | SPIDIF_RX0 |  |  | SDMMC2_CMD | FMC_NE1 |  |  | EVENT OUT
89 |  | PB3 / JTDO / TRASCESWO | O | FT | JTDOTRACESWO | TIM2_CH2 |  |  |  | SPI1_SCK / I2S1_CK | SPI3_SCKI / 2S3_CK |  | SPI6_SCK |  | SDMMC2_D2 | CAN3_RX | UART7_RX |  |  | EVENT OUT
90 |  | PB4 / NJTRST | I | FT | NJTRST |  | TIM3_CH1 |  |  | SPI1_MISO | SPI3_MISO | SPI2_NSS / I2S2_WS | SPI6_MISO |  | SDMCC2_D3 | CAN3_TX | UART7_TX |  |  | EVENT OUT
91 |  | PB5 | O | FT |  | UART5_RX | TIM3_CH2 |  | I2C1_SMBA | SPI1_MOSI / I2S1_SD | SPI3_MOSI / I2S3_SD |  | SPI6_MOSI | CAN2_RX | OTG_HS_ULPI_D7 | ETH_PPS_OUT | FMC_SDCKE1 | DCMI_D10 | LCD_G7 | EVENT OUT
92 |  | PB6 | IRQ | FT |  | UART5_TX | TIM4_CH1 | HDMI-CEC | I2C1_SCL |  | DFSDM1_DATIN5 | USART1_TX |  | CAN2_TX | QUADSPI_BK1_NCS | I2C4_SCL | FMC_SDNE1 | DCMI_D5 |  | EVENT OUT
93 |  | PB7 | IRQ | FT |  |  | TIM4_CH2 |  | I2C1_SDA |  | DFSDM1_CKIN5 | USART1_RX |  |  |  | I2S4_SDA | FMC_NIL | DCMI_VSYNC
94 |  | BOOT0 | I | B |  |  |  |  |  |  |  |  |  |  |  |  |  |  |  |  | VPP
95 |  | PB8 | O | FT |  | I2C4_SCL | TIM4_CH3 | TIM10_CH1 | I2C1_SCL |  | DFSDM1_CKIN7 | UART5_RX |  | CAN1_RX | SDMCC2_D4 | ETH_MII_TXD3 | SDMMC_D4 | DCMI_D6 | LCD_B6 | EVENT OUT
96 |  | PB9 | IRQ | FT |  | I2C4_SDA | TIM4_CH4 | TIM11_CH1 | I2C1_SDA | SPI2_NSS / I2S2_WS | DFSDM1_DATIN7 | UART5_TX |  | CAN1_TX | SDMCC2_D5 | I2C4_SMBA | SDMCC_D5 | DCMI_D7 | LCD_B7 | EVENT OUT
97 |  | PE0 | O | FT |  |  | TIM4_ETR | LPTIM1_ETR |  |  |  |  | UART8_RX |  | SAI2_MCK_A |  | FMC_NBL0 | DCMI_D2 |  | EVENT OUT
98 |  | PE1 | IRQ | FT |  |  |  | LPTIM1_IN2 |  |  |  |  | UART8_TX |  |  |  | FMC_NBL1 | DCMI_D3 |  | EVENT OUT
99 |  | VSS | S | __
100 |  | VDD | S | __
