bouLED/bouled/simulation/README.md

# Visualizing the orientation

 Run `make` and then run `main`. It accepts quaternions on stdin, as in:
 `python -u createquater.py | ./main`

# Face numbering

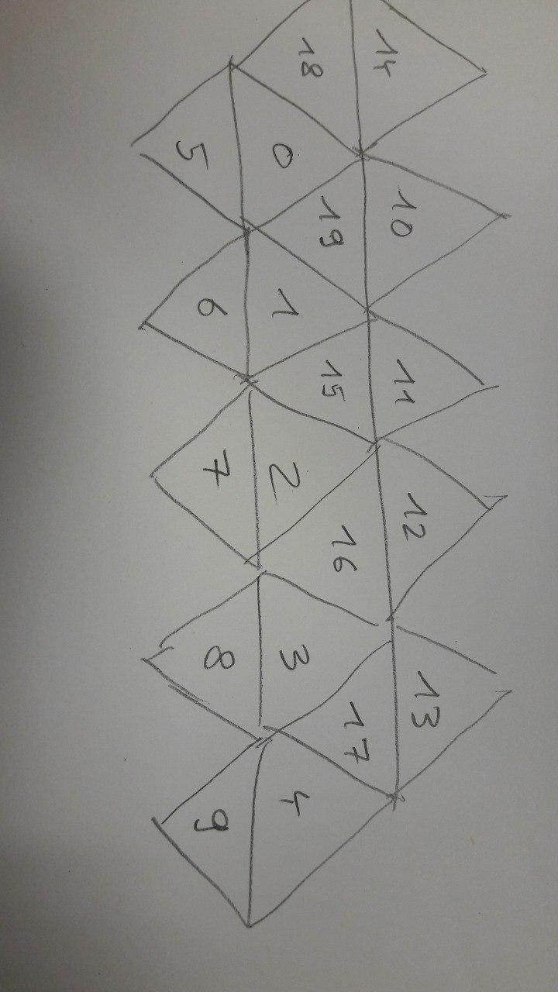
[picture p1: simulation/facetnumbering.jpg]
