bouLED/bouled/simulation/coloured_world.jpg

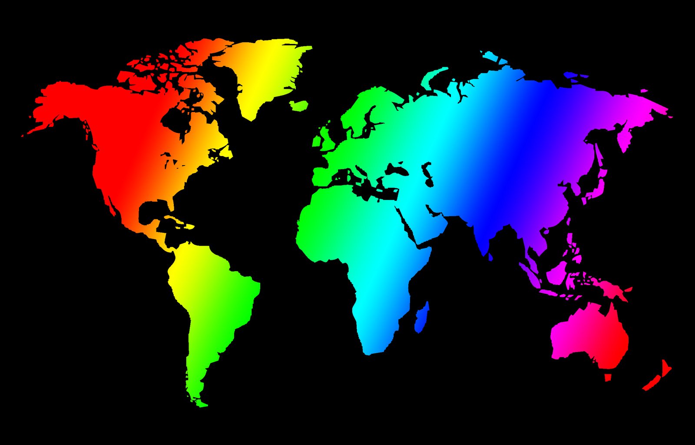
simulation/coloured_world.jpg
