bouLED/bouled/design/LED_Panel/Assembly/BOM.xlsx

Part | Value | Device | Package | Description | Description2 | Qty | Place | Provided_by_customer | Distributor | Ordernumber | Weblink | Remarks_customer | Unit_price | Total_price | REMARKS_BETA | OPTION1 | OPTION2 | OPTION3
D62,D63,D64,D65,D66,D67,D70,D68,D71,D69,D72,D73,D74,D75,D76,D77,D78,D1,D2,D3,D4,D5,D6,D7,D10,D11,D12,D13,D14,D15,D16,D17,D18,D20,D8,D19,D21,D22,D23,D24,D25,D26,D27,D28,D30,D9,D29,D31,D32,D33,D34,D35,D36,D37,D38,D40,D39,D41,D42,D43,D44,D45,D46,D47,D48,D50,D49,D51,D52,D53,D54,D55,D56,D57,D60,D58,D61,D59 | APA102C | APA102C | APA102C | RGB LED, SPI controlled, 5V, APA102C |  | 78 | YES |  |  |  |  | Stock: |  |  |  | 20-0075
J1 | B2B-PH-SM4-TB | B2B-PH-SM4-TB | B2B-PH-SM4-TB | Embase mâle CMS JST 2 broches, 2mm, avec détrompeur, à sortie verticale, B2B-PH-SM4-TB | Connecteur fil-à-carte, 2 mm, 2 Contact(s), Embase, Série PH, Montage CMS, 1 Rangée(s) | 1 | YES |  | Farnell | 9492534 | Click here | Stock: 51320 |  |  |  | 70-0086
C1 | 2.2nF | CAP C0603 2.2nF X7R50V | C0603 | Capacitor Ceramic X7R / 2.2nF / 50V / ±20% / case 0603 | Condensateur céramique multicouche CMS, 2200 pF, 50 V, 0402 [1005 Metric], ± 10%, X7R, GCM Series | 1 | YES |  | Farnell | 2688472 | Click here | Stock: 78178 |  |  |  | 10-0007
C4 | 10uF | CAP C0603 10uF X5R 10V | C0603 | Capacitor Ceramic X5R / 10uF / 10V / ±20% / case 0603 | Condensateur céramique multicouche CMS, 10 µF, 10 V, 0603 [1608 Metric], ± 20%, X5R, Série GRM | 1 | YES |  | Farnell | 2456110 | Click here | Stock: 22179 |  |  |  | 10-0120
C2 | 220nF | CAP C0805 220nF X7R 50V | C0805 | Capacitor Ceramic X7R / 220nF / 50V / ±1.25% / case 0805 | Condensateur céramique multicouche CMS, 0.22 µF, 50 V, 0805 [2012 Metric], ± 10%, X7R, Série GRM | 1 | YES |  | Farnell | 8820139 | Click here | Stock: 5657 |  |  |  | 10-0041
C3 | 2.2uF | CAP C1206 2.2uF X7R 25V | C1206 | Capacitor Ceramic X7R / 2.2uF / 25V / ±80% / case 1206 | Condensateur céramique multicouche CMS, FLEXITERM®, 2.2 µF, 25 V, 1206 [3216 Metric], ± 10%, X7R | 1 | YES |  | Farnell | 1301808 | Click here | Stock: 48 |  |  |  | 10-0056
C5 | 47uF | CAP C1210 47uF X5R 16V | C1210 | Capacitor Ceramic X5R / 47uF / 16V / ±10% / case 1210 / Murata GRM32ER61C476KE15L | Condensateur céramique multicouche CMS, 47 µF, 16 V, 1210 [3225 Metric], ± 10%, X6S, Série GRM | 1 | YES |  | Farnell | 1907527 | Click here | Stock: 32246 |  |  |  | 10-0095
U1 | LT1765ES8#PBF | LT1765ES8#PBF | SOP008_127_0500_0620_175 | 3A 1.25 MHz Step-down Converter / Linear Tech LT1765ES8#PBF / Adj output / case SOIC8 |  | 1 | YES |  | Mouser France | 584-LT1765ES8#PBF |  | Stock: |  |  |  | 40-0003
D79 | MBRS340 | MBRS340 | SMC | Diode Shottky 3A 0.5V OnSemi MBRS340 case SMC | Redresseur Schottky, 40 V, 3 A, Une, DO-214AB, 2 Broche(s), 500 mV | 1 | YES |  | Farnell | 9557377 | Click here | Stock: 115122 |  |  |  | 20-0001
D80 | MBR0540-T1 | MBR0540-T1 | SOD123 | Diode Shottky 500mA 0.5V OnSemi MBRS540 case SOD123 | Redresseur Schottky, 40 V, 500 mA, Une, SOD-123, 2 Broche(s), 510 mV | 1 | YES |  | Farnell | 9556923 | Click here | Stock: 42417 |  |  |  | 20-0019
J2,J3 | MICROMATCH-4 | MICROMATCH-4 | AMP7-188275-4 | 4pins smd on board connector Micromatch AMP 7-188275-4 | Connecteur carte-à-carte, 1.27 mm, 4 Contact(s), Embase, Série Micro-MaTch, Montage CMS | 2 | YES |  | Farnell | 3784710 | Click here | Stock: 10732 |  |  |  | 70-0014
R1 | 10K | RES_10.0k_0603 | R0603 | Resistor 10.0k ohms / 1% / case 0603 | Résistance à puce CMS, Couche mince, 0603 [1608 Metric], 10 kohm, Série CPF, 50 V, Couche mince | 1 | YES |  | Farnell | 1527581 | Click here | Stock: 32209 |  |  |  | 01-0385
R2 | 31.6K | RES_31.6k_0603 | R0603 | Resistor 31.6k ohms / 1% / case 0603 | Résistance à puce CMS, Céramique, 0603 [1608 Metric], 31.6 kohm, Série MCMR, 75 V, Couche épaisse | 1 | YES |  | Farnell | 2073469 | Click here | Stock: 897 |  |  |  | 01-0433
L1 | 8.2uH | SELF 8.2uH | XAL50 | Inductor blindée 8.2uH, 20%, 6.1A, 15MHz, 0.035ohms, Coilcraft XAL5050-822MEC, boitier 5.48x5.28 | Inductances de Puissance (CMS), 8.2 µH, 6.1 A, Blindé, 5.6 A, Série XAL5050 | 1 | YES |  | Farnell | 2289072 | Click here | Stock: 1471 |  |  |  | 50-0044
 |  |  |  |  | Total components
 |  |  |  |  | Total to solder
