bouLED/bouled/design/main_board/bouled_mainboard/Assembly/BOM.xlsx

Part | Value | Device | Package | Description | Description2 | Qty | Place | Provided_by_customer | Distributor | Ordernumber | Weblink | Remarks_customer | Unit_price | Total_price | REMARKS_BETA | OPTION1 | OPTION2 | OPTION3
D2 | B220A-13-F | B220A-13-F | SMA | Schottky diode, Imoy=2A, Vf=0.5V, Vr=20V, Diodes Inc B220A-13-F, case SMA | Redresseur Schottky, 20 V, 2 A, Une, SMD, 2 Broche(s), 500 mV | 1 | YES |  | Farnell | 1858604 | Click here | Stock: 5960 |  |  |  | 20-0064
C30 | 47uF | CAP CHIM C 47uF 6V3 | CHIMIQUE_C | Capacitor chimical for decoupling / 47uF / 6.3V / case C | Condensateur électrolytique alu CMS, Radial - CMS, 47 µF, 6.3 V, Série EXV, 3000 heures à 105°C | 1 | YES |  | Farnell | 2069145 | Click here | Stock: 5807 |  |  |  | 10-0019
C24,C29 | 10nF | CAP C0402 10nF X7R 16V | C0402 | Capacitor Ceramic X7R / 10nF / 16V / ±10% / case 0402 | Condensateur céramique multicouche CMS, 10000 pF, 50 V, 0402 [1005 Metric], ± 5%, X7R, MC Series | 2 | YES |  | Farnell | 2627338 | Click here | Stock: 1293 |  |  |  | 10-0059
C4 | 2.2nF | CAP C0603 2.2nF X7R50V | C0603 | Capacitor Ceramic X7R / 2.2nF / 50V / ±20% / case 0603 | Condensateur céramique multicouche CMS, 2200 pF, 50 V, 0402 [1005 Metric], ± 10%, X7R, GCM Series | 1 | YES |  | Farnell | 2688472 | Click here | Stock: 78178 |  |  |  | 10-0007
C5,C9 | 2.2uF | CAP C0603 2.2uF X5R 6.3V | C0603 | Capacitor Ceramic X5R / 2.2uF / 6.3V / ±20% / case 0603 | Condensateur céramique multicouche CMS, 2.2 µF, 6.3 V, 0603 [1608 Metric], ± 10%, X5R | 2 | YES |  | Farnell | 2496924 | Click here | Stock: 3580 |  |  |  | 10-0112
C25 | 10uF | CAP C0603 10uF X5R 10V | C0603 | Capacitor Ceramic X5R / 10uF / 10V / ±20% / case 0603 | Condensateur céramique multicouche CMS, 10 µF, 10 V, 0603 [1608 Metric], ± 20%, X5R, Série GRM | 1 | YES |  | Farnell | 2456110 | Click here | Stock: 22179 |  |  |  | 10-0120
C22,C23 | 15pF | CAP C0603 15pF COG 10V | C0603 | Capacitor Ceramic 15pF / 10V / ±1% / case 0603 | Condensateur céramique multicouche CMS, 15 pF, 10 V, 0603 [1608 Metric], ± 1%, C0G / NP0 | 2 | YES |  | Farnell | 1856081 | Click here | Stock: 3440 |  |  |  | 10-0031
C7,C13,C14,C15,C16,C17,C8,C27,C28 | 100nF | CAP C0603 100nF X7R 16V | C0603 | Capacitor Ceramic X7R / 100nF / 16V / ±10% / case 0603 | Condensateur céramique multicouche CMS, FT-CAP, 0.1 µF, 16 V, 0603 [1608 Metric], ± 10%, X7R | 9 | YES |  | Farnell | 1414027 | Click here | Stock: 11455 |  |  |  | 10-0057
C3,C6,C18,C20,C21,C19 | 10uF | CAP C0805 10uF X5R 10V | C0805 | Capacitor Ceramic X5R / 10uF / 10V / ±10% / case 0805 | Condensateur céramique multicouche CMS, 10 µF, 10 V, 0805 [2012 Metric], ± 10%, X7R, GCJ Series | 6 | YES |  | Farnell | 2781411 | Click here | Stock: 23059 |  |  |  | 10-0061
C2 | 10uF | CAP C0805 10uF X5R 25V | C0805 | Capacitor Ceramic X5R / 10uF / 25V / ±10% / case 0805, | Condensateur céramique multicouche CMS, 10 µF, 25 V, 0805 [2012 Metric], ± 10%, X5R, Série GRM | 1 | YES |  | Farnell | 1735530 | Click here | Stock: 180705 |  |  |  | 10-0102
C1 | 220nF | CAP C0805 220nF X7R 50V | C0805 | Capacitor Ceramic X7R / 220nF / 50V / ±1.25% / case 0805 | Condensateur céramique multicouche CMS, 0.22 µF, 50 V, 0805 [2012 Metric], ± 10%, X7R, Série GRM | 1 | YES |  | Farnell | 8820139 | Click here | Stock: 5657 |  |  |  | 10-0041
U4 | ESP32_DEVKITC | ESP32_DEVKITC | ESP32_DEVKITC | ESP32 DevKitC module, with VROOM submodule. |  | 1 | YES |  | Mouser France | 356-ESP32-DEVKITC |  | Stock: |  |  |  | 80-0073
J8 | FTSH-105-01-L-DV | FTSH-105-01-L-DV | FTSH-105-01-L-DV | Dual row 1.27 CMS 2x5 points connector, Samtec FTSH-105-01-L-DV | Connecteur carte-à-carte, 1.27 mm, 10 Contact(s), Embase, Série FTSH, Montage CMS, 2 Rangée(s) | 1 | YES |  | Farnell | 1667759 | Click here | Stock: 6563 |  |  |  | 70-0081
D3 | HSMF-C114 | HSMF-C114 | CHIPLED | Tricolor RGB LED, SMD case ChipLed, Avago HSMF-C114, 20mA, 70/180/85mCd, Vf=2.4/3.9/2.9V | LED, RVB, Rouge, Vert, Bleu, CMS, 145 °, Rectangulaire, R 20mA, G 20mA, B 20mA | 1 | YES |  | Farnell | 1058362 | Click here | Stock: 5 |  |  |  | 20-0038
J1 | JAE_ST1W008S4ER1500 | JAE_ST1W008S4ER1500 | JAE_ST1W008S4ER1500 | Connecteur MicroSD, à charnière, JAE ST1W008S4ER1500 |  | 1 | YES |  | Mouser France | 656-ST1W008S4ER1500 |  | Stock: |  |  |  | 70-0058
J9 | JUMPER 5PTS | JUMPER 5PTS | BAR05P2.54/W2.54_1 | Barrette droite 5 points en ligne 2.54mm |  | 1 | YES |  |  |  |  | Stock: |  |  |  | 70-0111
U3 | LT1762EMS8-5#PBF | LT1762EMS8-5#PBF | MS08_065_300_300_110 | Low noise LDO 5V regulator, 150mA, Linear Tech LT1762EMS8-5#PBF, case MSOP8 |  | 1 | YES |  | Mouser France | 584-LT1762EMS8-5#PBF |  | Stock: |  |  |  | 40-0166
U1 | LT1765ES8#PBF | LT1765ES8#PBF | SOP008_127_0500_0620_175 | 3A 1.25 MHz Step-down Converter / Linear Tech LT1765ES8#PBF / Adj output / case SOIC8 |  | 1 | YES |  | Mouser France | 584-LT1765ES8#PBF |  | Stock: |  |  |  | 40-0003
D1 | MBR0540-T1 | MBR0540-T1 | SOD123 | Diode Shottky 500mA 0.5V OnSemi MBRS540 case SOD123 | Redresseur Schottky, 40 V, 500 mA, Une, SOD-123, 2 Broche(s), 510 mV | 1 | YES |  | Farnell | 9556923 | Click here | Stock: 42417 |  |  |  | 20-0019
J20,J18,J21,J19 | MICROMATCH-4 | MICROMATCH-4 | AMP7-188275-4 | 4pins smd on board connector Micromatch AMP 7-188275-4 | Connecteur carte-à-carte, 1.27 mm, 4 Contact(s), Embase, Série Micro-MaTch, Montage CMS | 4 | YES |  | Farnell | 3784710 | Click here | Stock: 10732 |  |  |  | 70-0014
U6 | MPU9250 | MPU9250 | QFN24E_040_300_300_100 | 3 axis gyroscope - accéléromètre - magnétomètre, +/- 250 à 2000°/s, 2-16g, +/-1200uT, 3.3V, I2C, SPI, Ivensense MPU9250, case QFN24 0.4mm |  | 1 | YES |  | Mouser France | 410-MPU-9250 |  | Stock: |  |  |  | 40-0301
J4,J5,J6,J7,J10,J11,J12,J13,J14,J15,J16,J17 | PAD-1x1 | PAD-1x1 | PAD_1x1 | Pad for test, 1x1mm |  | 12 | YES |  |  |  |  | Stock: |  |  |  | 70-0085
R20 | 0 | RES_0_0603 | R0603 | Resistor 0 ohms / 5% / case 0603 | Résistance à puce CMS, Couche mince, 0603 [1608 Metric], 10 kohm, Série CPF, 50 V, Couche mince | 1 | YES |  | Farnell | 2008343 | Click here | Stock: 32209 |  |  |  | 00-0001
R5,R6,R7,R10,R11,R12,R13,R14,R15,R16 | 1K | RES_1.0k_0603 | R0603 | Resistor 1.0k ohms / 5% / case 0603 | Résistance à puce CMS, Couche épaisse, 0603 [1608 Metric], 1 kohm, Série RC, 75 V, Couche épaisse | 10 | YES |  | Farnell | 2309108 | Click here | Stock: 123480 |  |  |  | 00-0074
R18,R19 | 4.7K | RES_4.7k_0603 | R0603 | Resistor 4.7k ohms / 5% / case 0603 | Résistance à puce CMS, Couche épaisse, 0603 [1608 Metric], 4.7 kohm, Série MCWR, 50 V | 2 | YES |  | Farnell | 2447385 | Click here | Stock: 41947 |  |  |  | 00-0090
R8 | 10K | RES_10.0k_0603 | R0603 | Resistor 10.0k ohms / 1% / case 0603 | Résistance à puce CMS, Couche mince, 0603 [1608 Metric], 10 kohm, Série CPF, 50 V, Couche mince | 1 | YES |  | Farnell | 1527581 | Click here | Stock: 32209 |  |  |  | 01-0385
R1,R17 | 10K | RES_10k_0603 | R0603 | Resistor 10k ohms / 5% / case 0603 | Résistance à puce CMS, Céramique, 0603 [1608 Metric], 10 kohm, Série MCSR 06, 75 V, Céramique | 2 | YES |  | Farnell | 2074170 | Click here | Stock: 838 |  |  |  | 00-0098
R9 | 18K | RES_18k_0603 | R0603 | Resistor 18k ohms / 5% / case 0603 | Résistance à puce CMS, Couche épaisse, 0603 [1608 Metric], 18 kohm, Série RC, 75 V, Couche épaisse | 1 | YES |  | Farnell | 9238638 | Click here | Stock: 56354 |  |  |  | 00-0104
R2,R3,R4 | 20K | RES_20k_0603 | R0603 | Resistor 20k ohms / 5% / case 0603 | Résistance à puce CMS, Couche mince, 0603 [1608 Metric], 20 kohm, Série CPF, 50 V, Couche mince | 3 | YES |  | Farnell | 1527615 | Click here | Stock: 1414 |  |  |  | 00-0105
L1 | 8.2uH | SELF 8.2uH | XAL50 | Inductor blindée 8.2uH, 20%, 6.1A, 15MHz, 0.035ohms, Coilcraft XAL5050-822MEC, boitier 5.48x5.28 | Inductances de Puissance (CMS), 8.2 µH, 6.1 A, Blindé, 5.6 A, Série XAL5050 | 1 | YES |  | Farnell | 2289072 | Click here | Stock: 1471 |  |  |  | 50-0044
U2 | STM32H743VIT6 | STM32H743VIT6 | TQFP100_050_1630_1630_160 | Cortex M7, 400MHz, ST STM32H743VIT6, case TQFP100 | Microcontrôleur ARM, STM32 Family STM32H7 Series Microcontrollers, ARM Cortex-M7, 32 bits, 400 MHz | 1 | YES |  | Farnell | 2820776 | Click here | Stock: 428 |  |  |  | 40-0358
J2 | S2B-PH-SM4-TB | S2B-PH-SM4-TB | S2B-PH-SM4-TB | Embase mâle CMS JST 2 broches, 2mm, avec détrompeur, à sortie horizontale, S2B-PH-SM4-TB | Connecteur fil-à-carte, Angle Droit, 2 mm, 2 Contact(s), Embase, Série PH, Montage CMS, 1 Rangée(s) | 1 | YES |  | Farnell | 9492615 | Click here | Stock: 94629 |  |  |  | 70-0066
QZ1 | 16.000 MHz | 16.000 MHz | OSCCMS_CX2016DB | Quartz 16.000 MHz, +/- 15ppm, 8pF, SMD, Kyocera CX2016DB16000D0FLJCC |  | 1 | YES |  | Mouser France | 581-CX2016DB16DFLJCC |  | Stock: |  |  |  | 83-0028
U5 | 74LVC4245APW | 74LVC4245APW | TSSOP024_065_0780_0660_110 | 8 bits level shifter, 3.3V --> 5V, NXP 74LVC4245APW , case TSSOP24 | Transceiver, 3 états, 1.5V à 3.6V, 1.5V à 5.5V, TSSOP-24 | 1 | YES |  | Farnell | 1631648 | Click here | Stock: 2007 |  |  |  | 40-0234
 |  |  |  |  | Total components
 |  |  |  |  | Total to solder
