bouLED/bouled/(list of files, cad)

Other CAD files:
3dstructure/prototype_triangle/prototype_lasercut.scad
