bouLED/bouled/design/LED_Panel/Assembly/PDF/Assembly_Fiducials.pdf

PCB

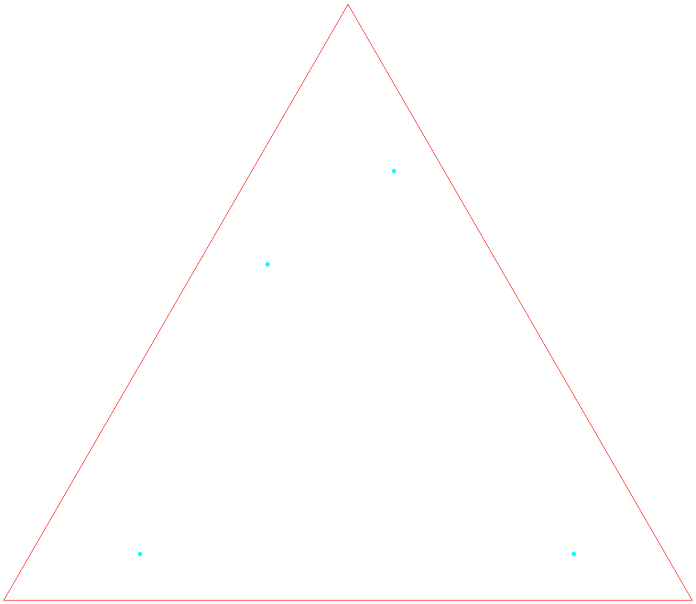
[picture p3: figure]

Fiducials_top

PCB

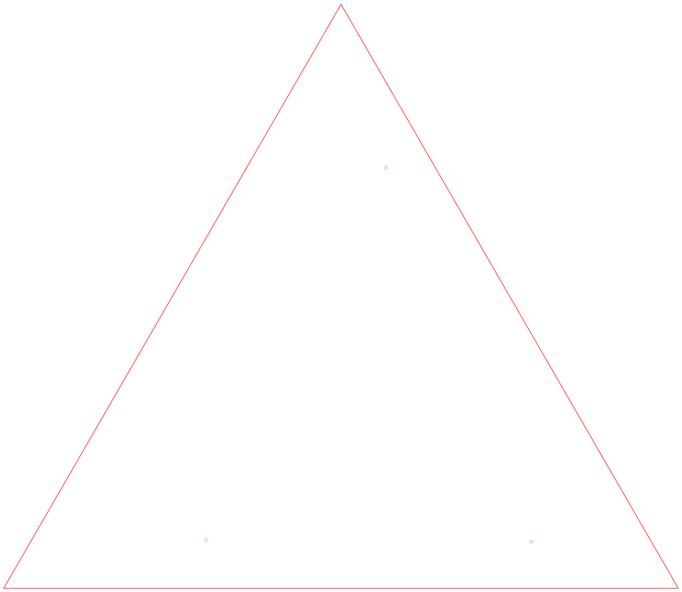
[picture p4: figure]

Fiducials_bottom
