bouLED/bouled/design/main_board/bouled_mainboard/Assembly/PDF/Assembly_Fiducials.pdf

PCB

Fiducials_top | footbar

PCB

Fiducials_bottom | footbar
