bouLED/bouled/design/main_board/mainboard.pdf

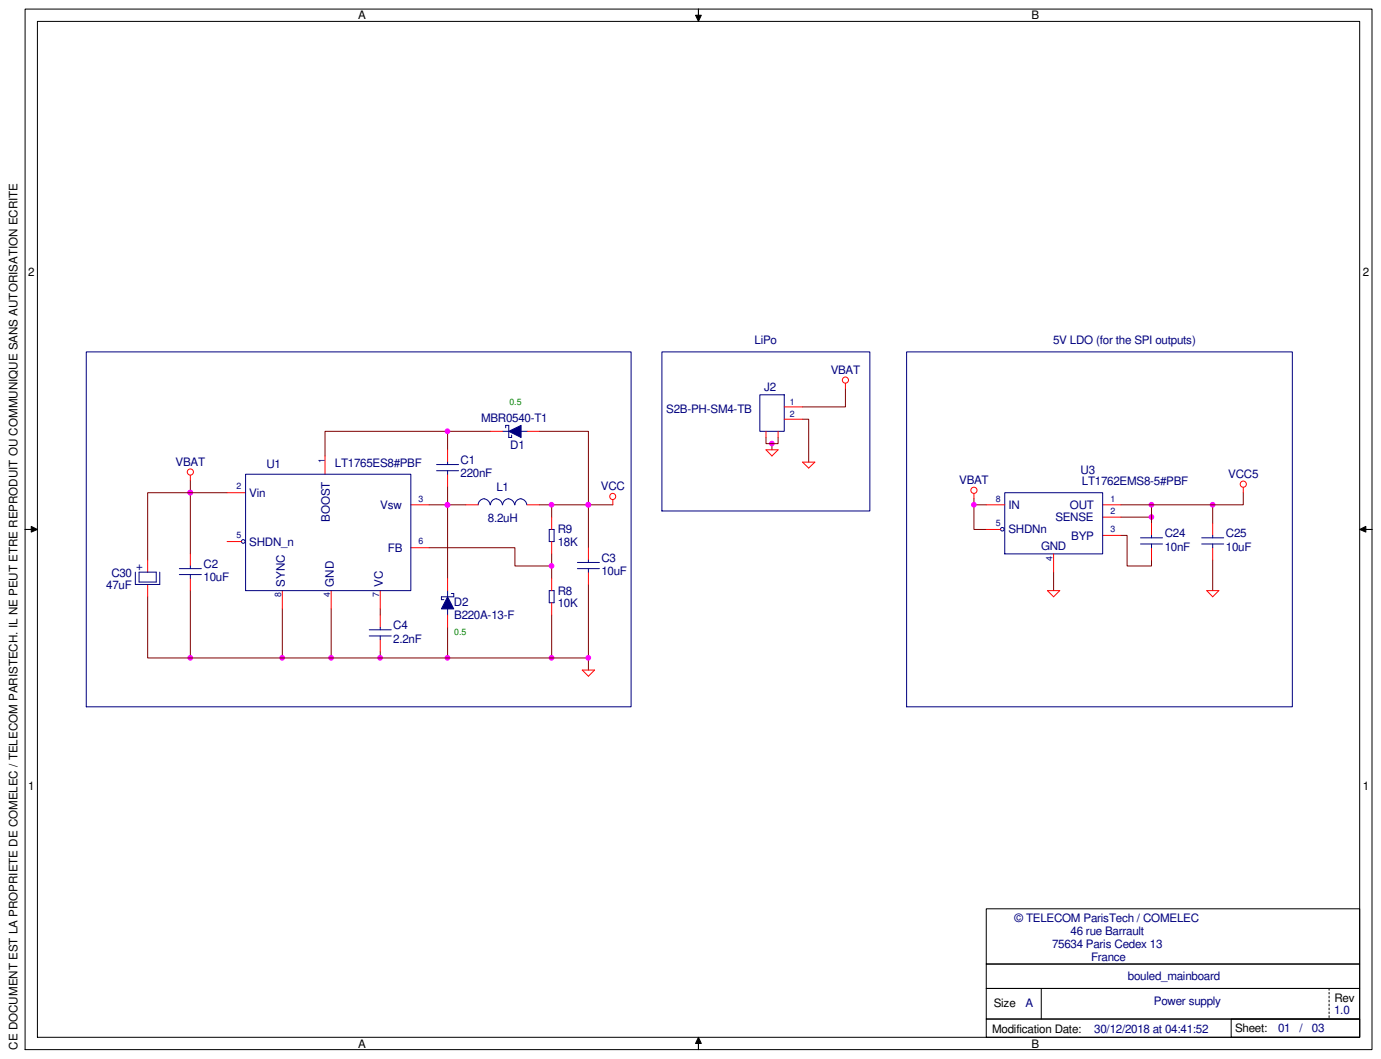
[picture p5: page 1]

CE DOCUMENT EST LA PROPRIETE DE COMELEC / TELECOM PARISTECH. IL NE PEUT ETRE REPRODUIT OU COMMUNIQUE SANS AUTORISATION ECRITE Rev Modification Date: Sheet: Size A © TELECOM ParisTech / COMELEC 46 rue Barrault 75634 Paris Cedex 13 France 10uF C2 C30 47uF

5V LDO (for the SPI outputs)

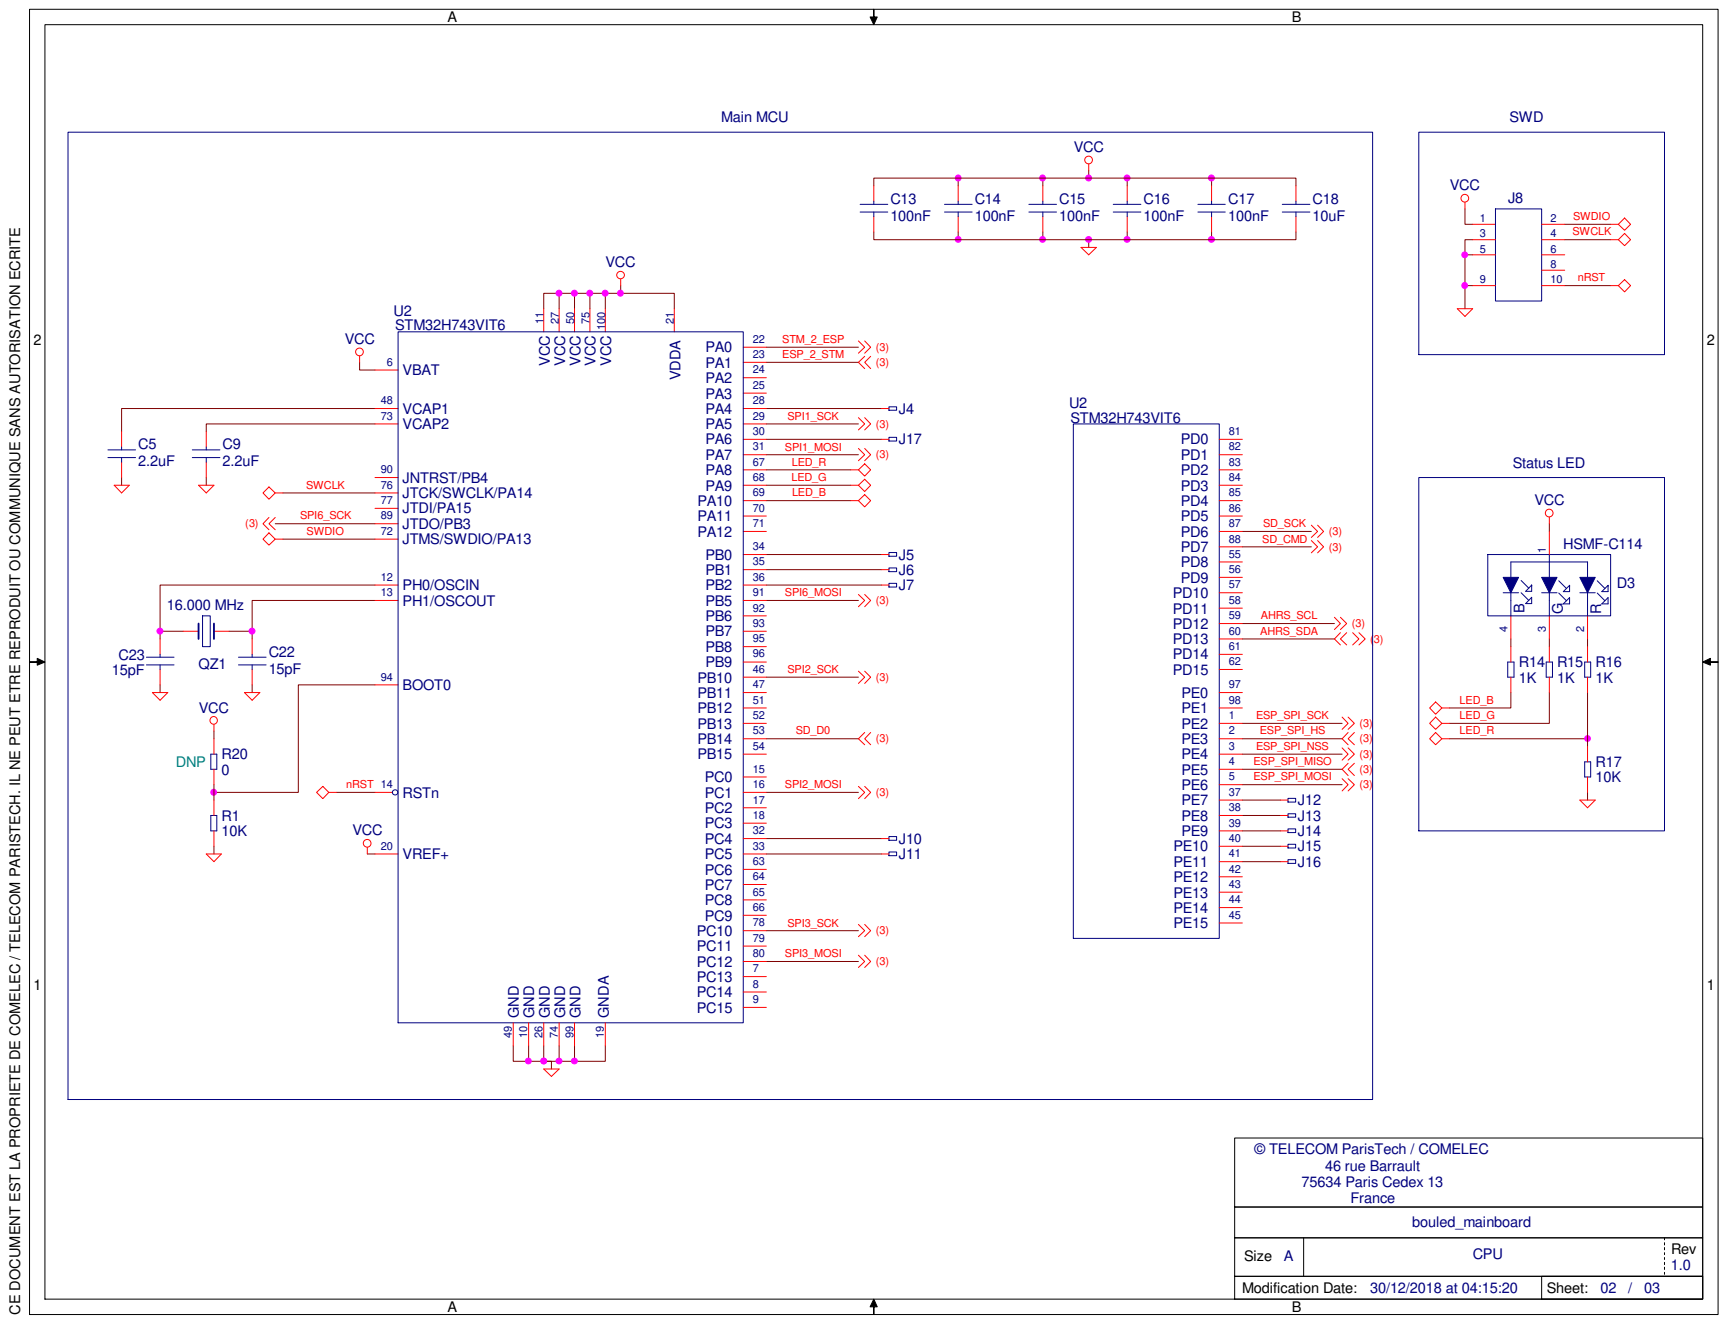
[picture p6: page 2]
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

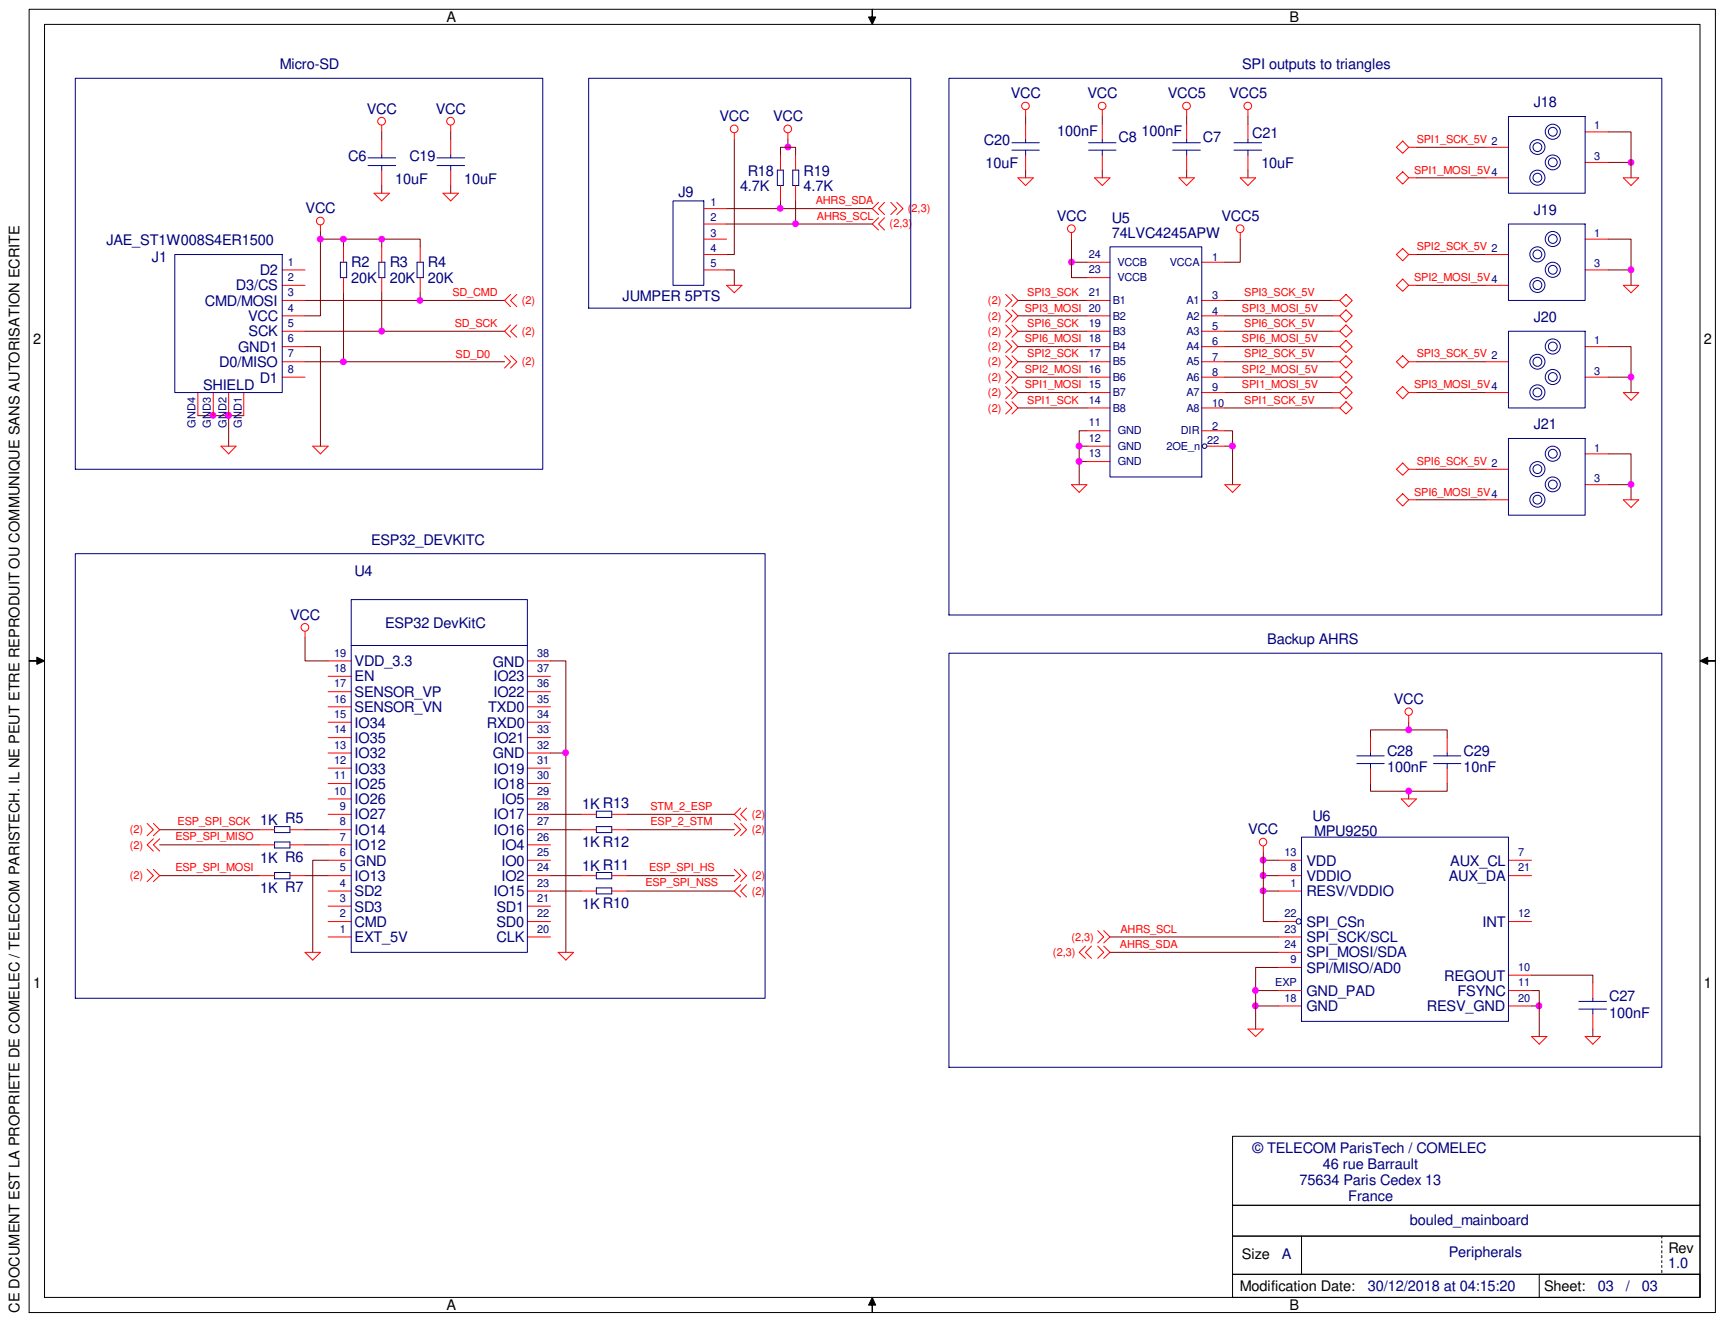
[picture p7: page 3]

SPI outputs to triangles

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
