bouLED/bouled/design/LED_Panel/Assembly/PDF/Assembly_Bottom.pdf

# PCB

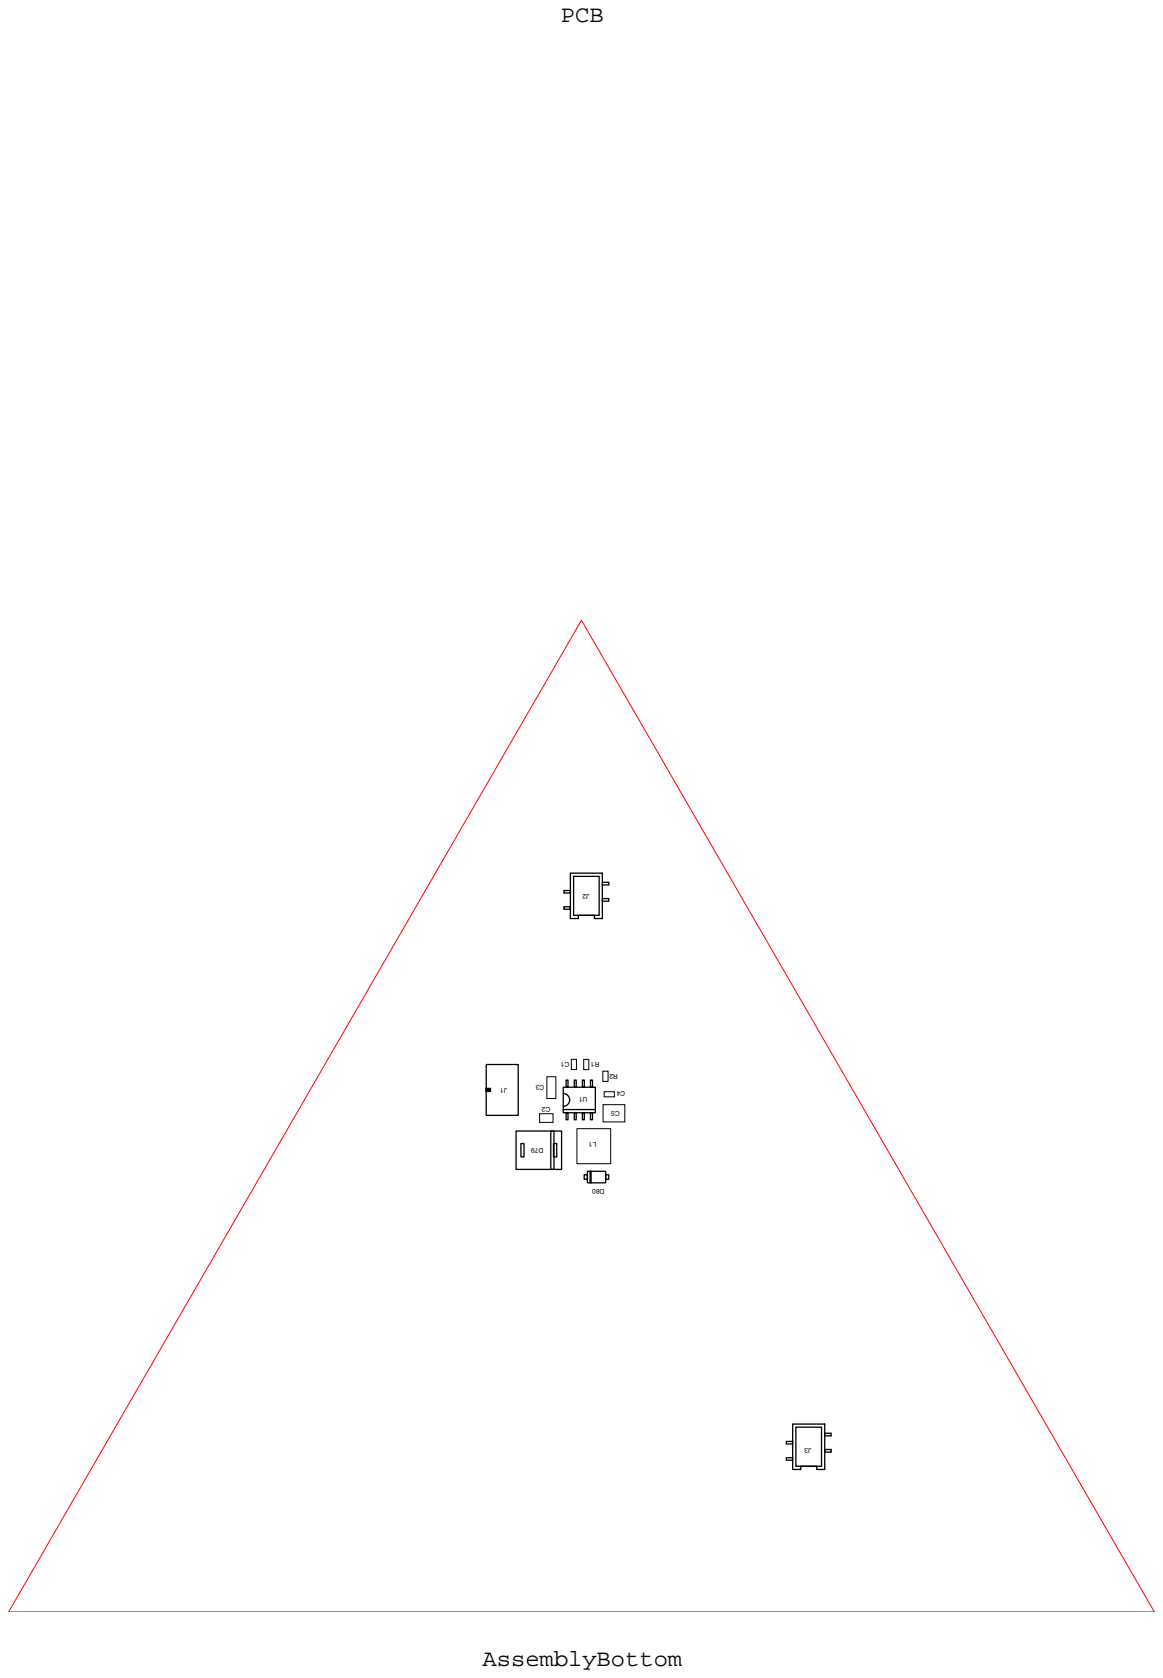
[picture p8: page 1]
