bouLED/bouled/design/LED_Panel/Assembly/PDF/Assembly_Top.pdf

# PCB

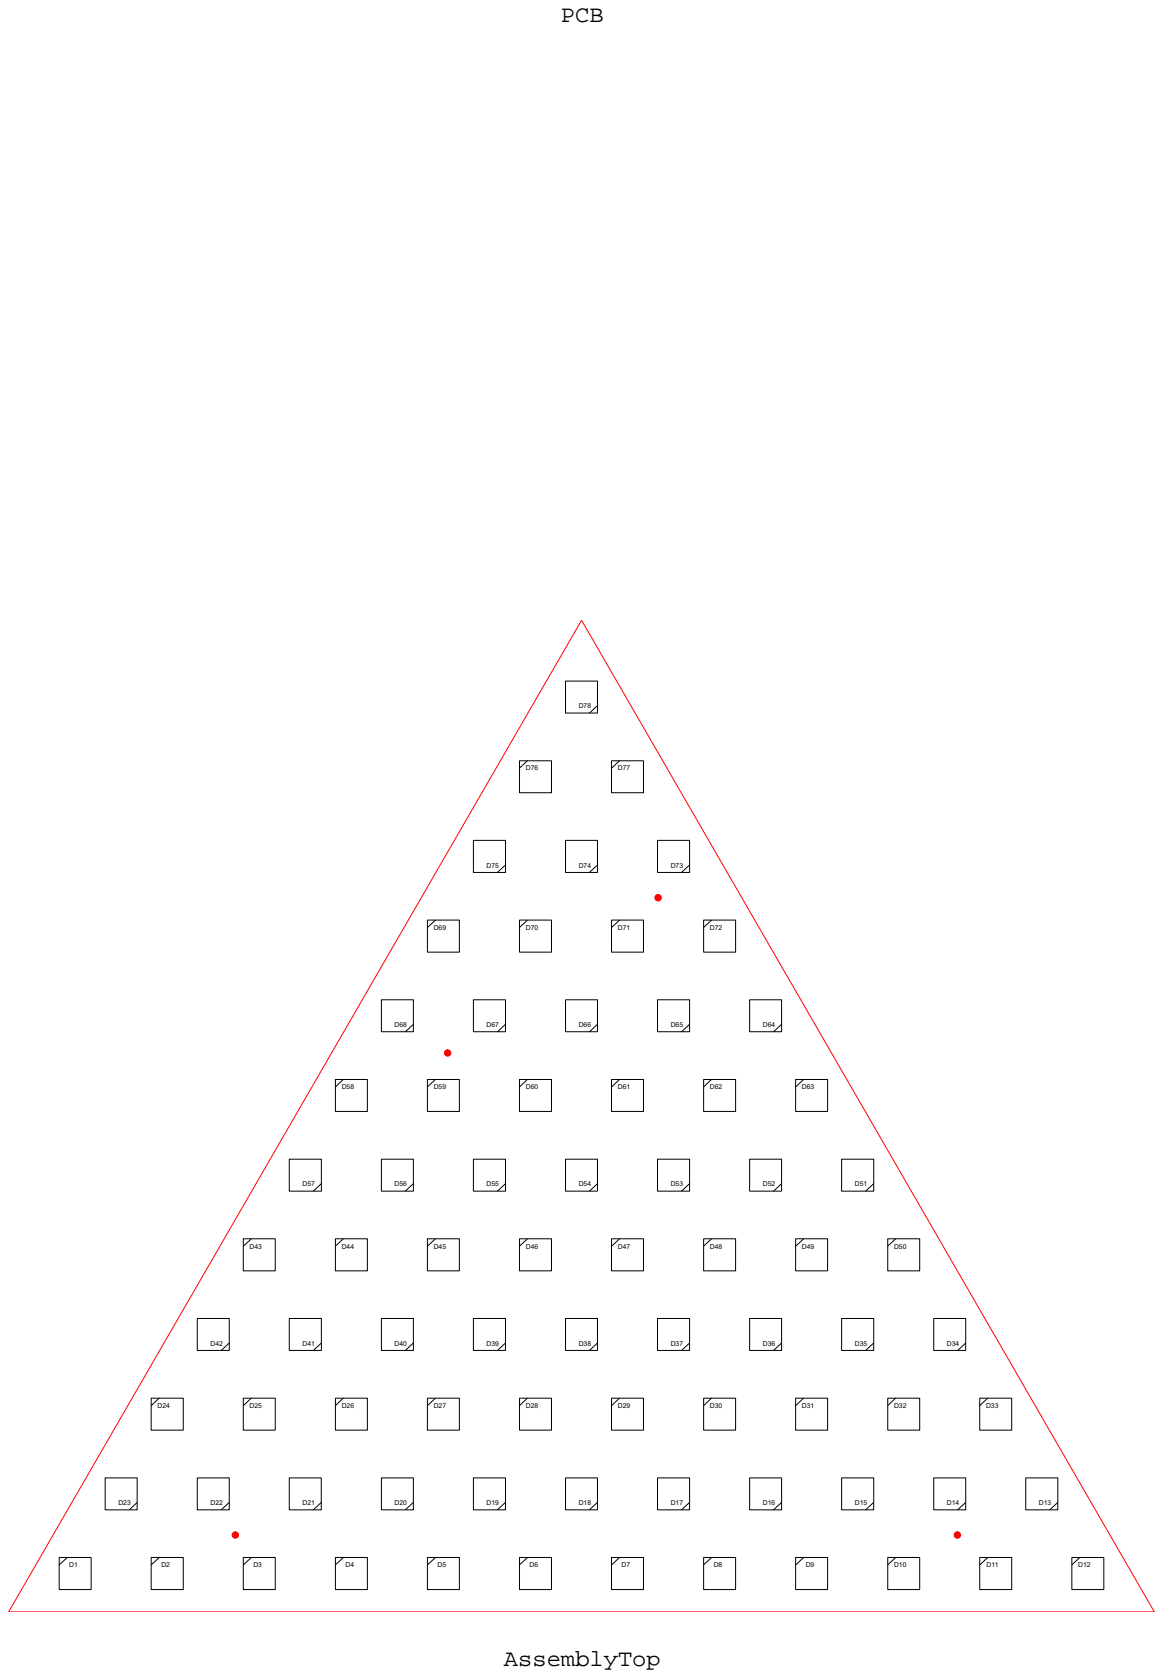
[picture p9: page 1]
