bouLED/bouled/design/LED_Panel/Assembly/PDF/PCB.pdf

# Top layer

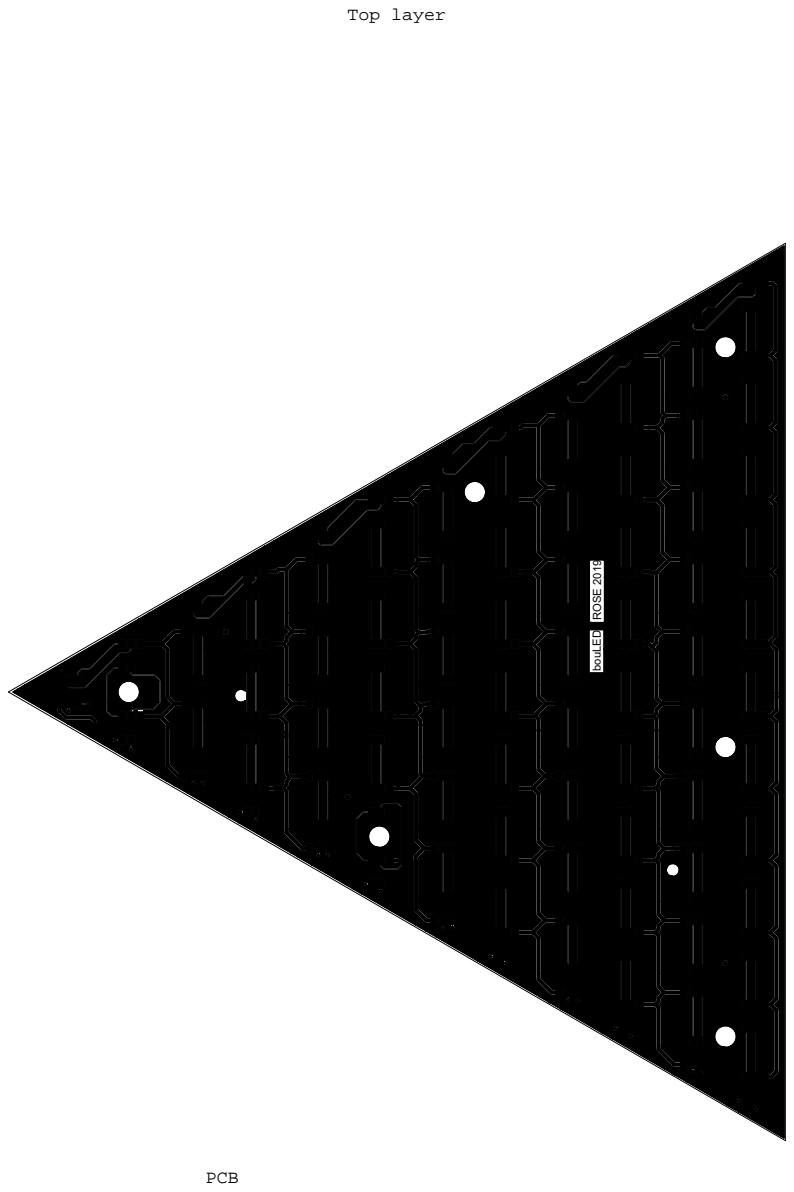
[picture p10: page 1]
PCB; bouLED ROSE 2019

# Bottom Layer

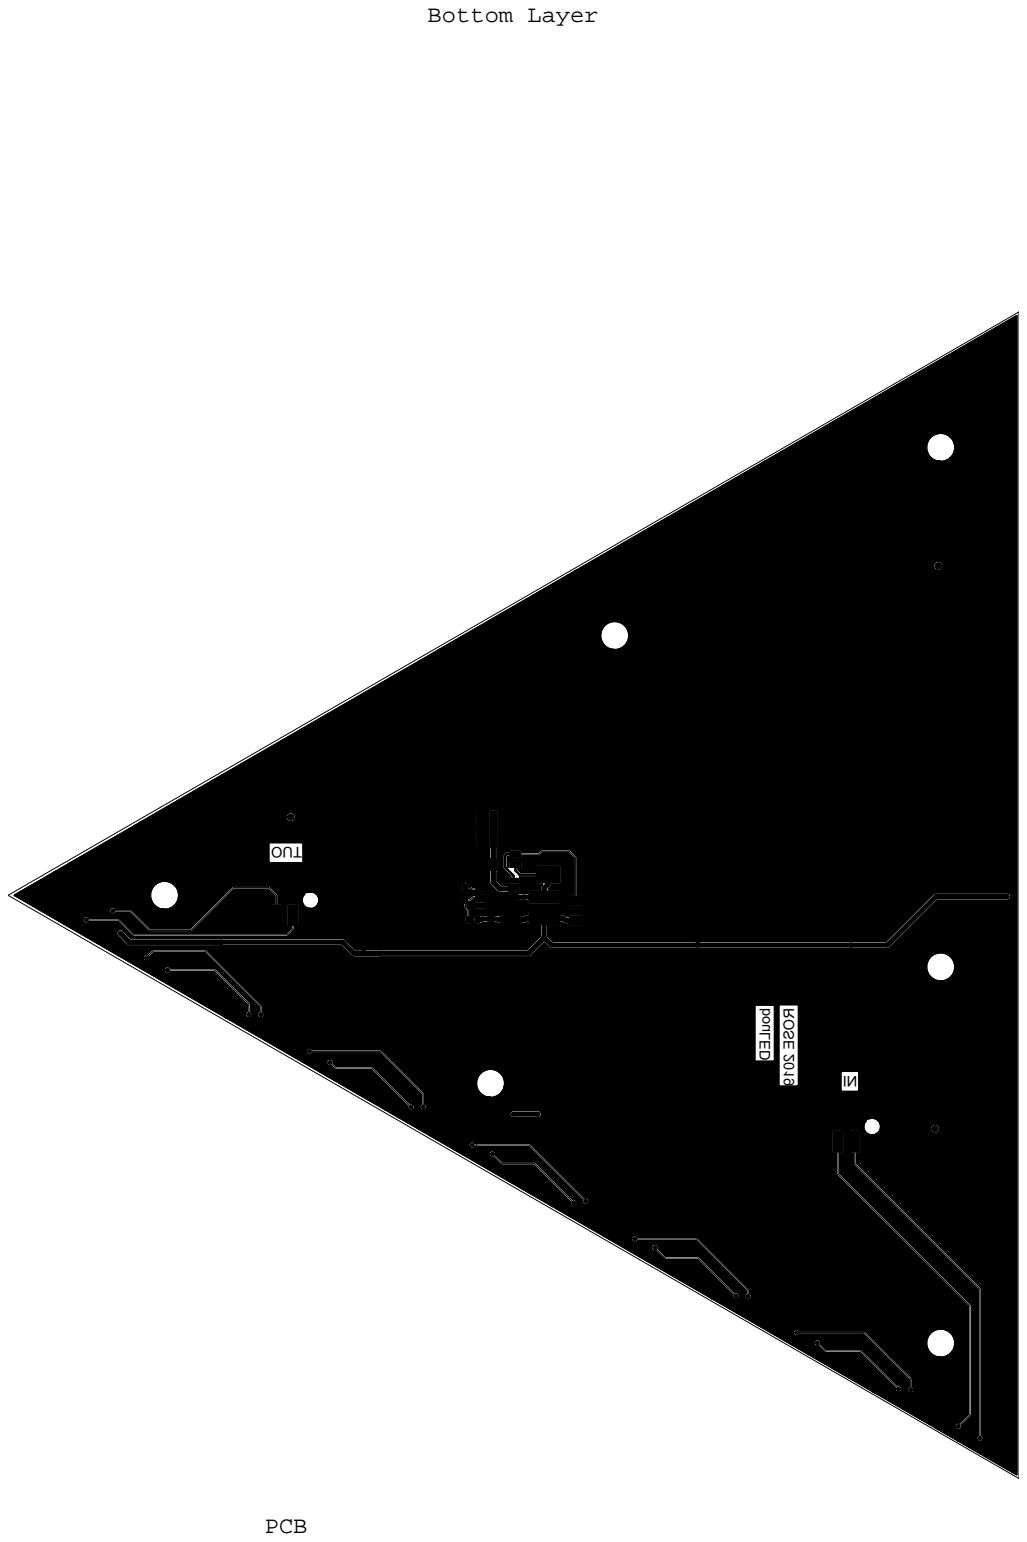
[picture p11: page 2]
PCB; bouLED; ROSE 2019IN; OUT

# Assembly Top

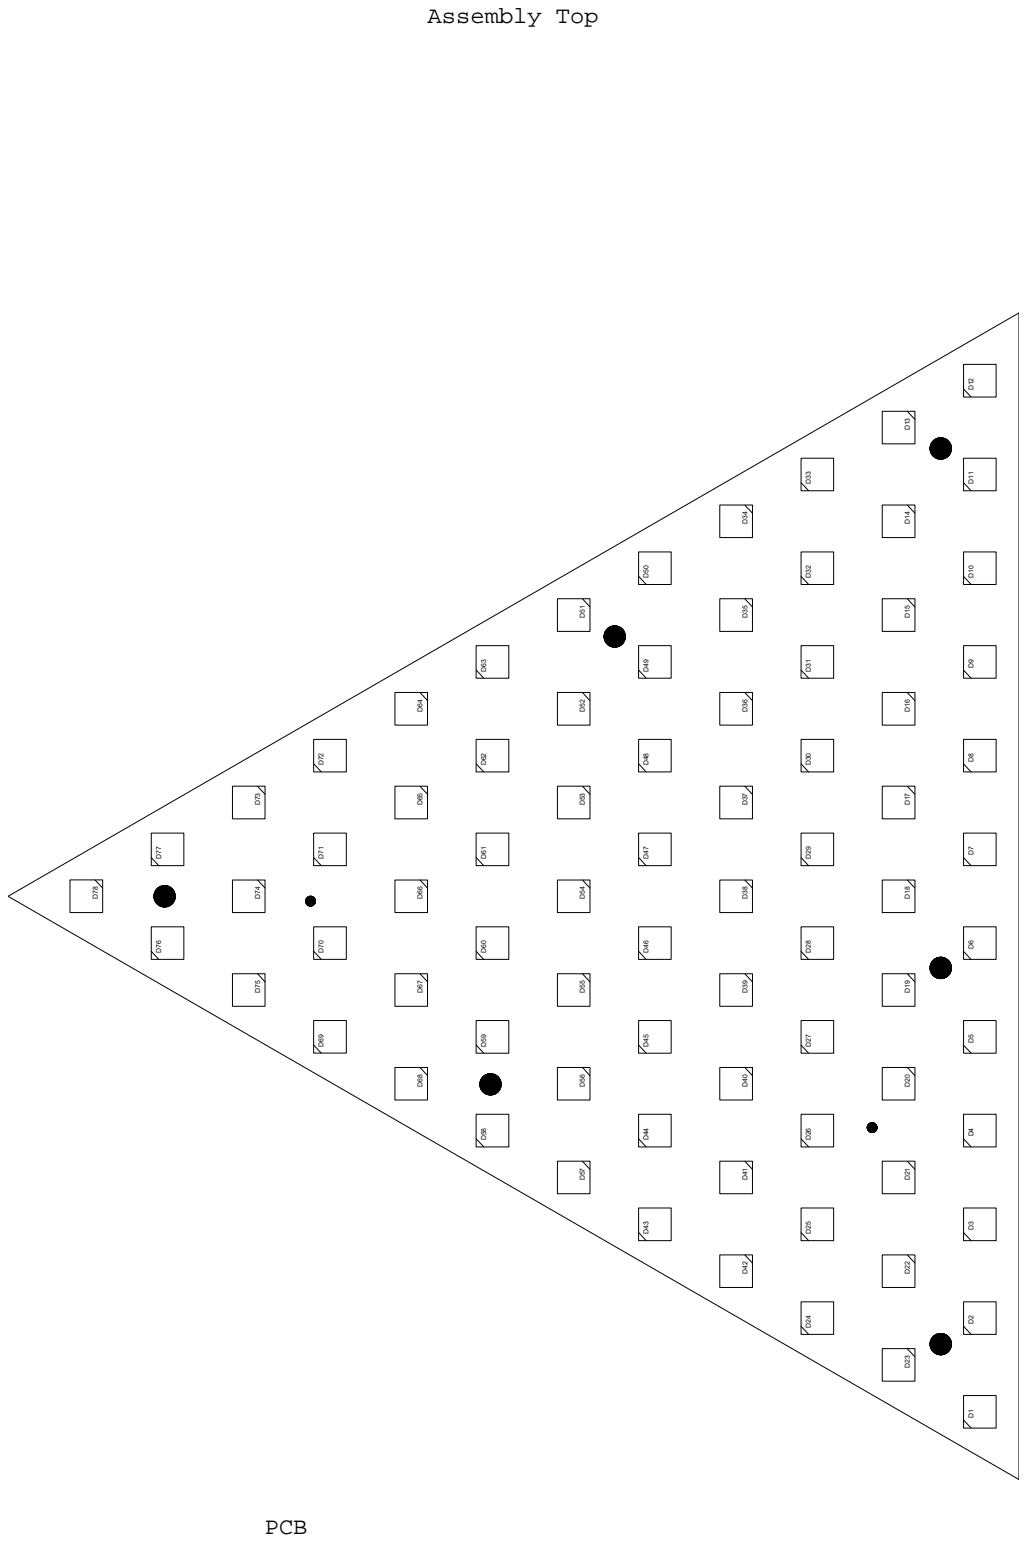
[picture p12: page 3]

# Assembly Bottom

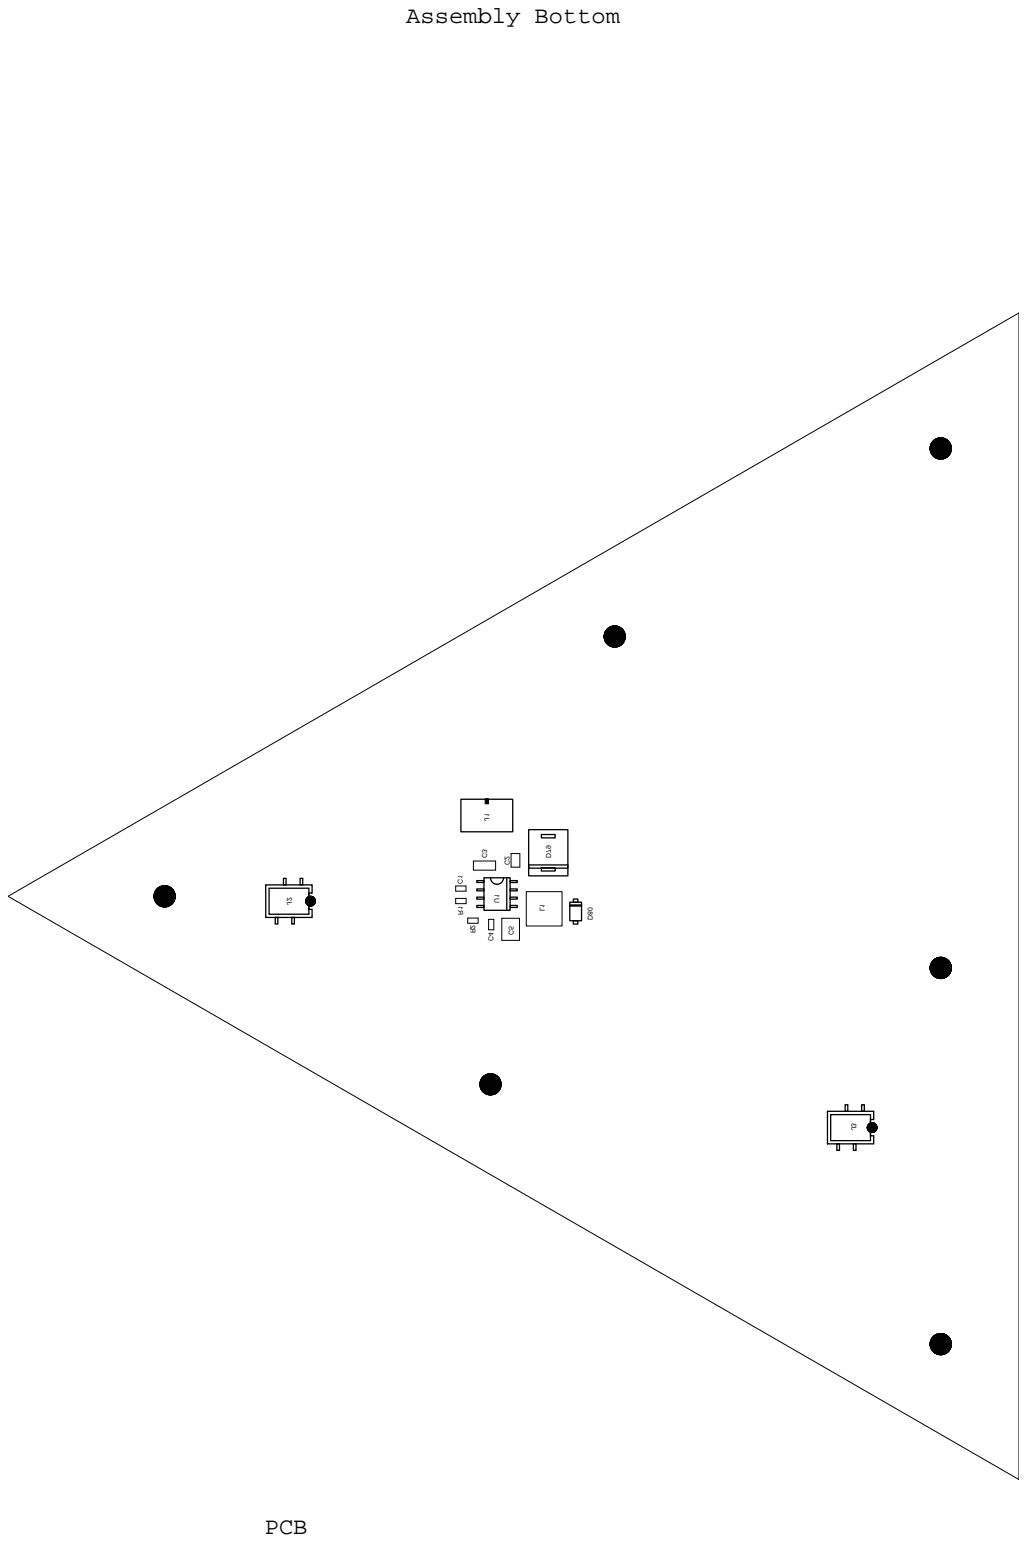
[picture p13: page 4]

# Silk Screen Top

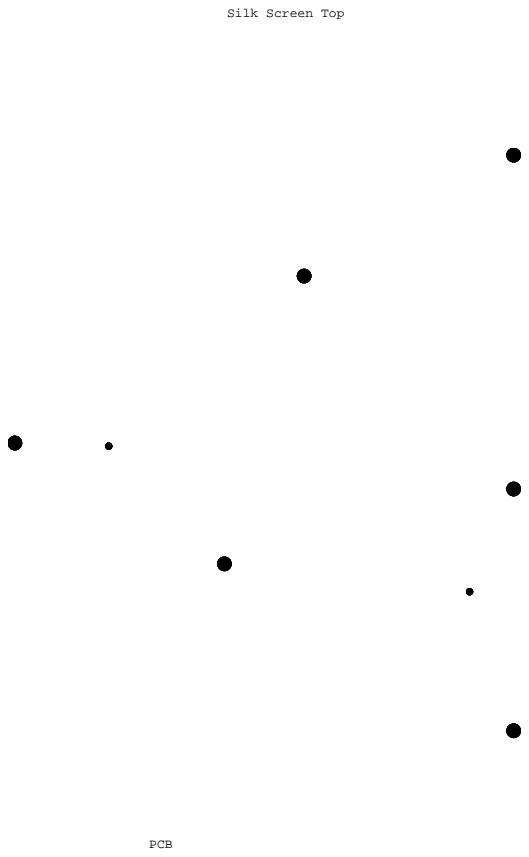
[picture p14: page 5]
PCB

# Silk Screen Bottom

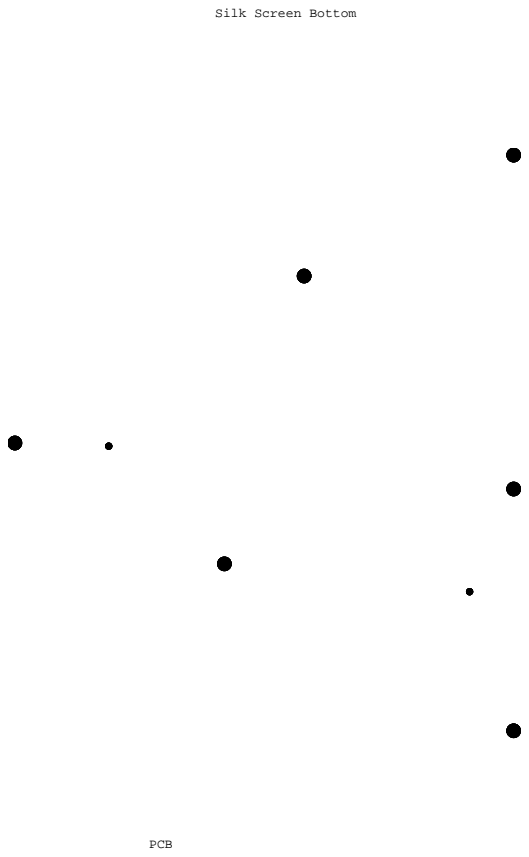
[picture p15: page 6]
PCB
