bouLED/bouled/design/LED_Panel/Assembly/PDF/PCB_Human.pdf

# PCB

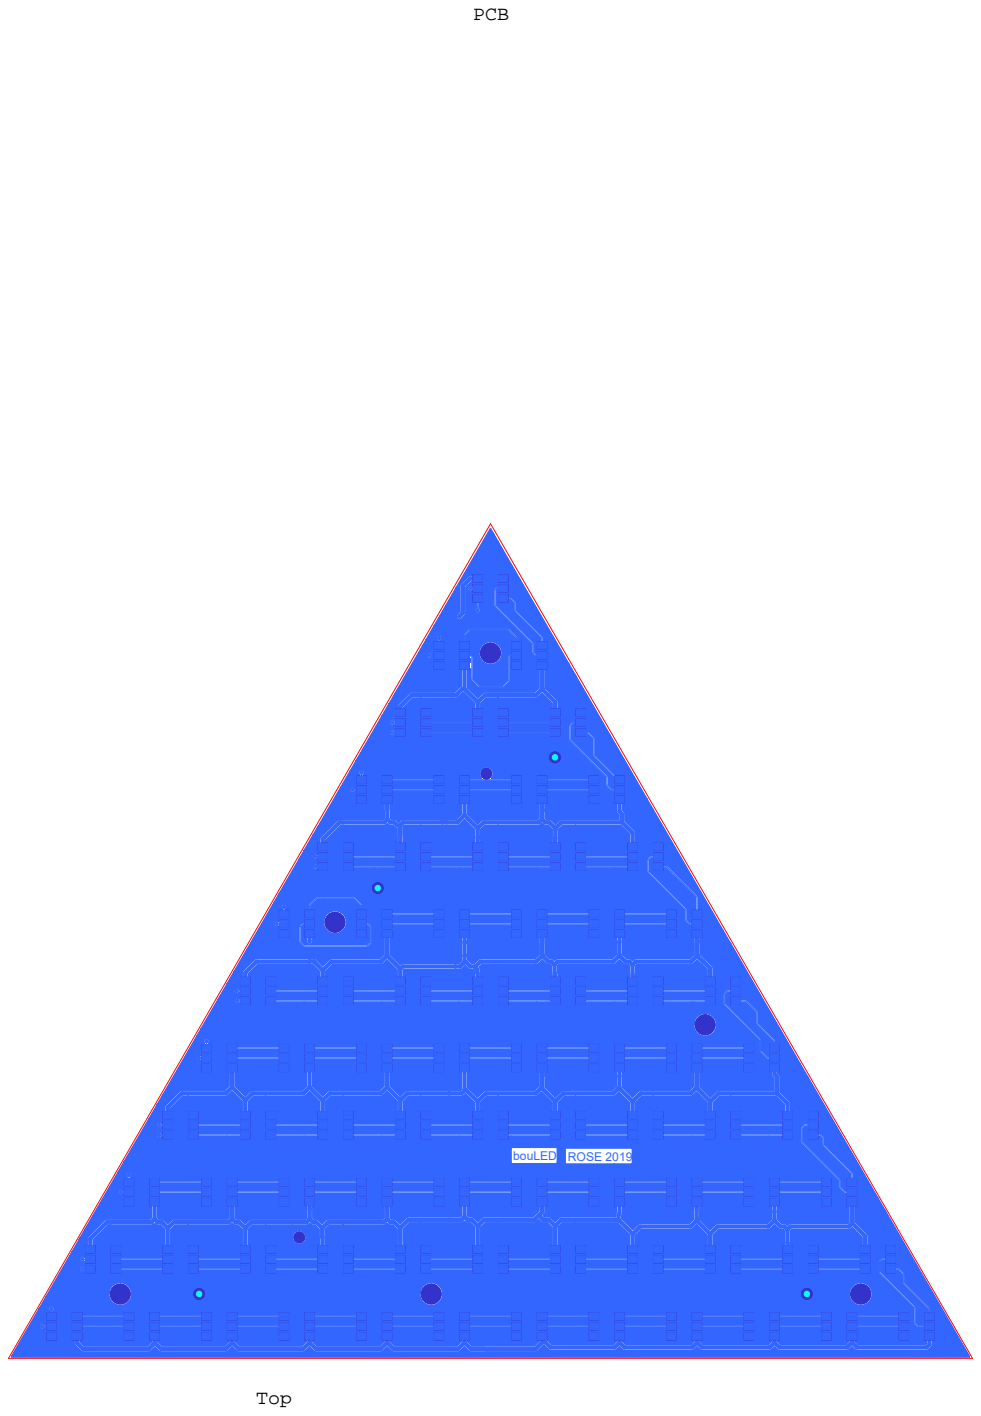
[picture p16: page 1]
Top; bouLED ROSE 2019

# PCB

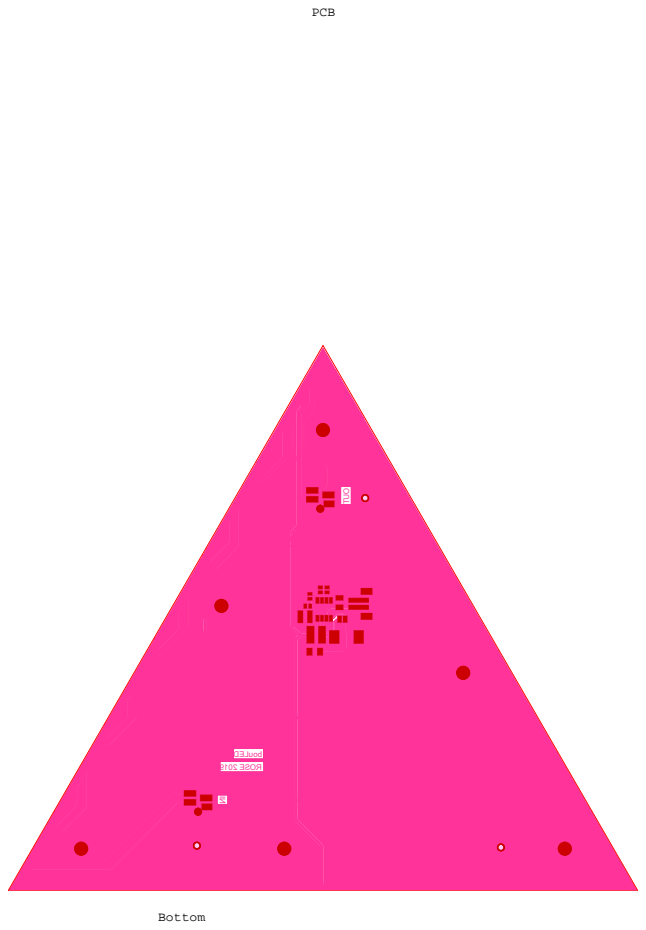
[picture p17: page 2]
Bottom; OUT

# PCB

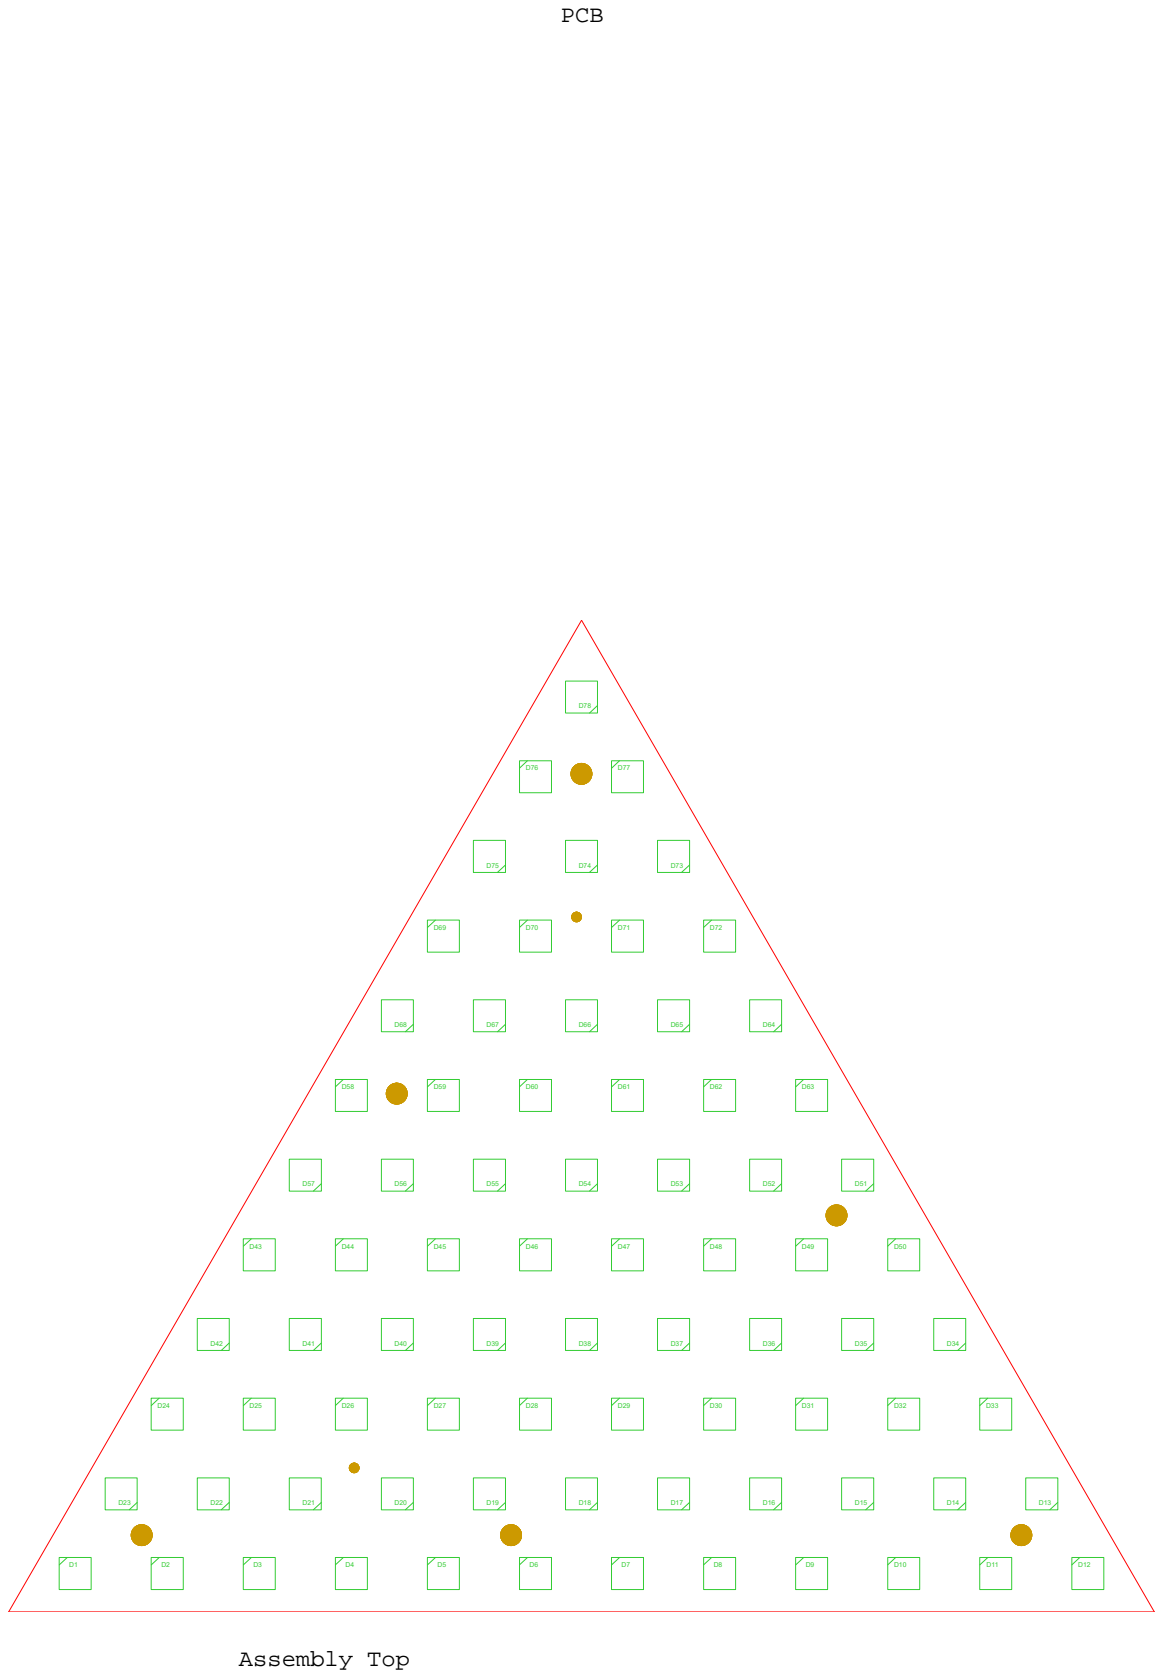
[picture p18: page 3]

# PCB

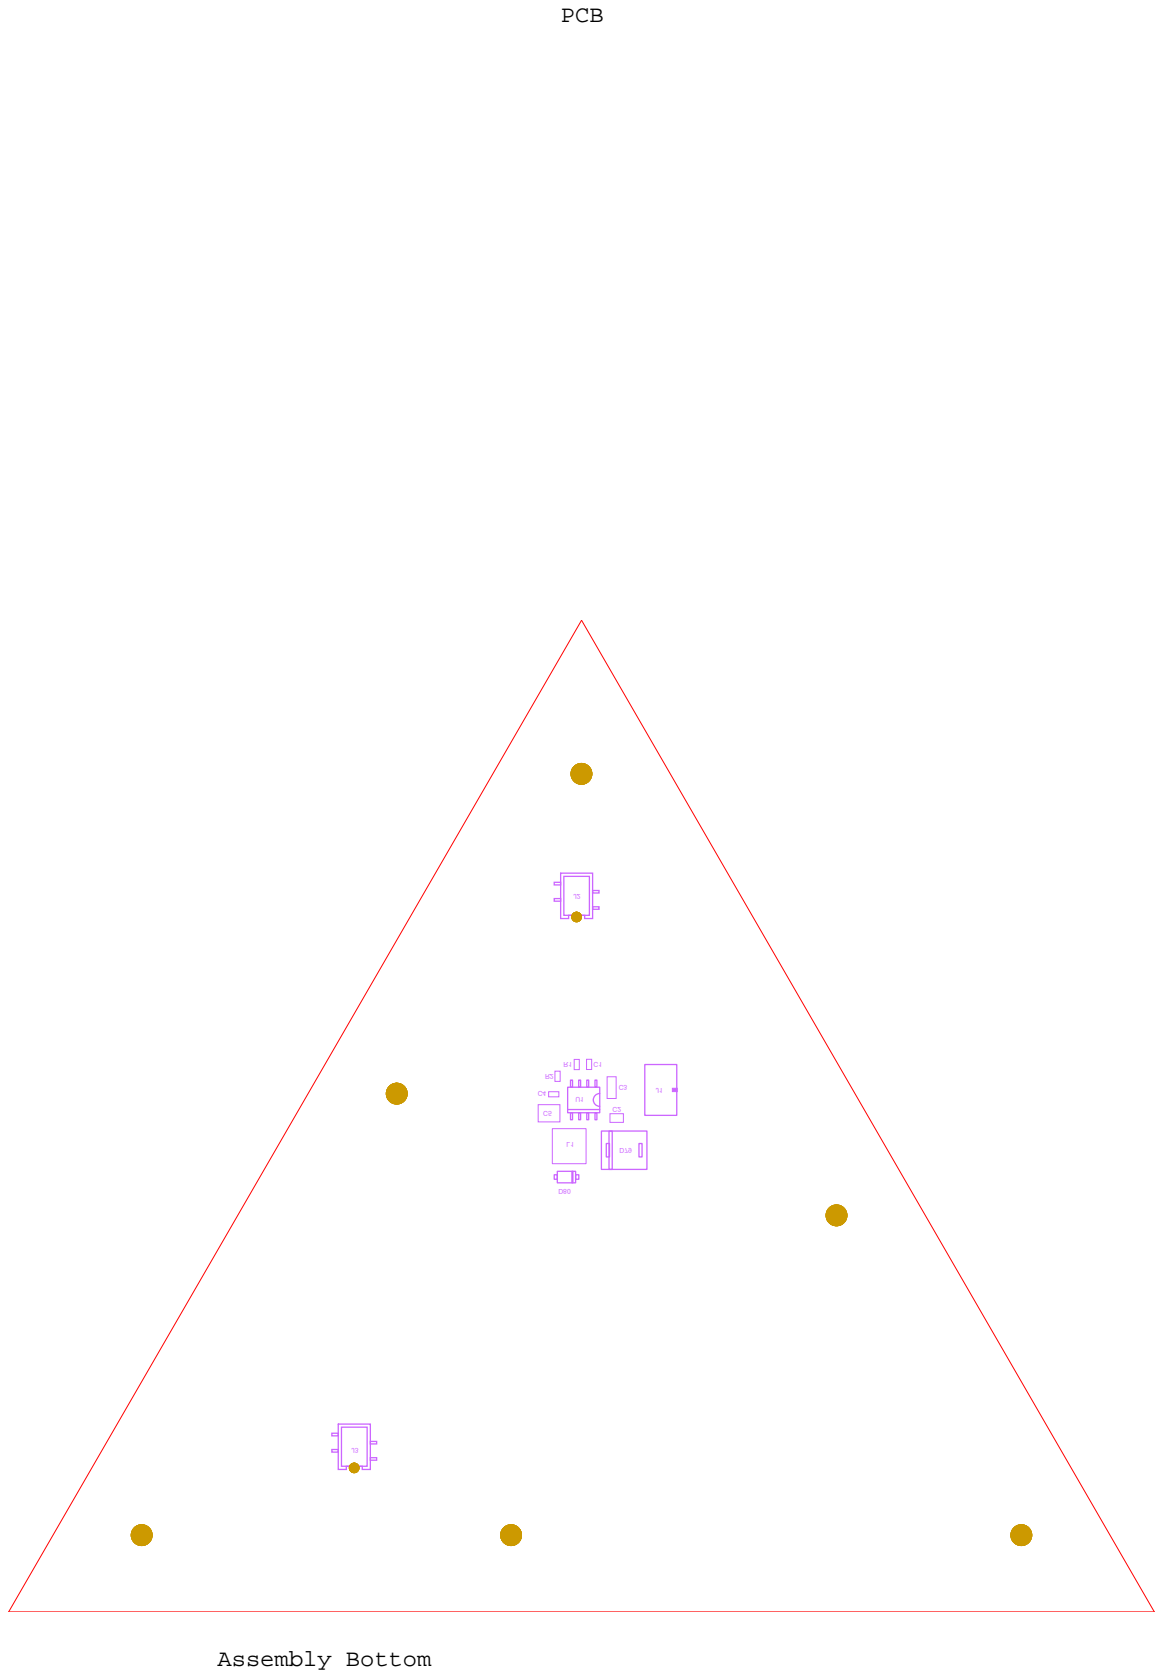
[picture p19: page 4]

# PCB

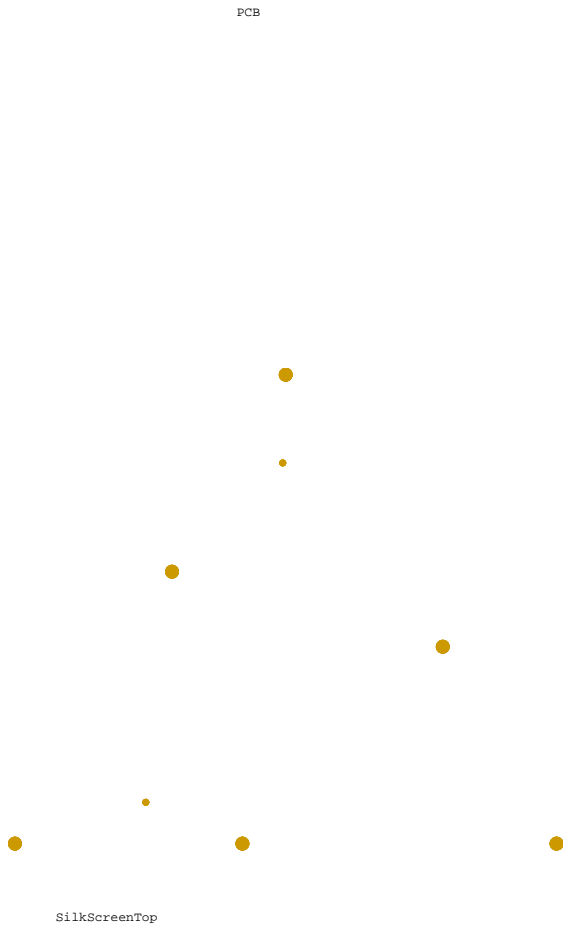
[picture p20: page 5]
SilkScreenTop

# PCB

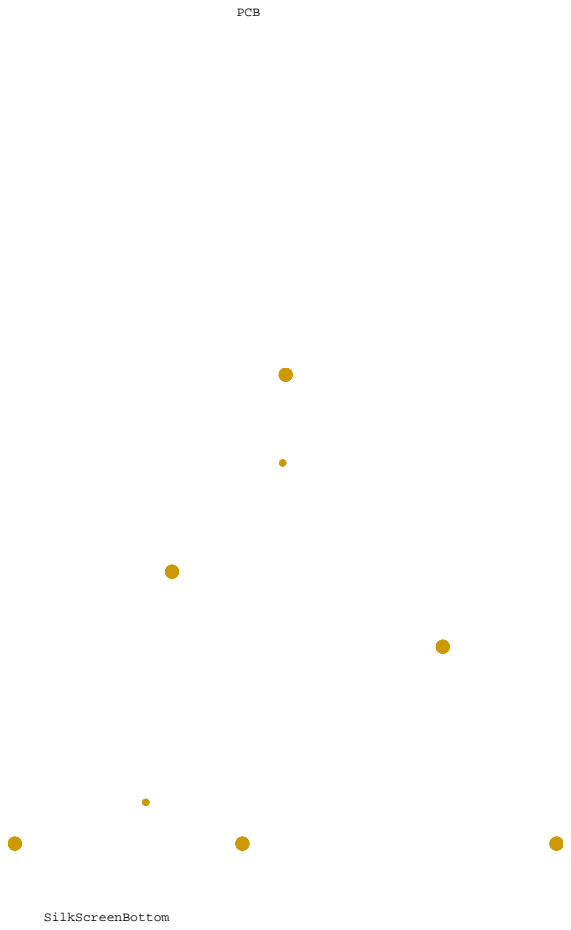
[picture p21: page 6]
SilkScreenBottom

# PCB

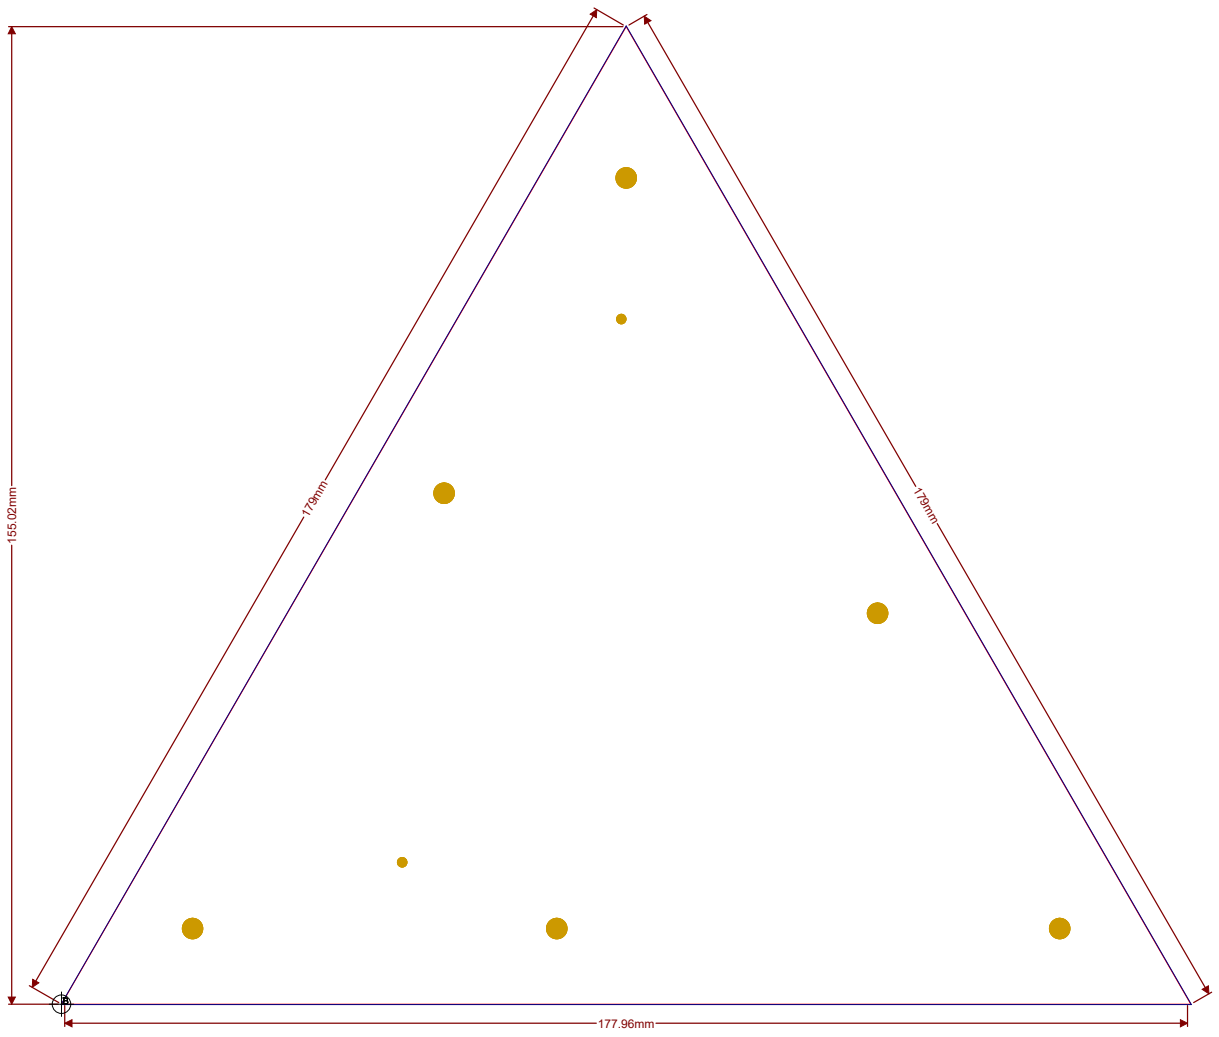
[picture p22: figure]

# Dimensions
