bouLED/bouled/design/main_board/bouled_mainboard/Assembly/PDF/Assembly_Top.pdf

### PCB

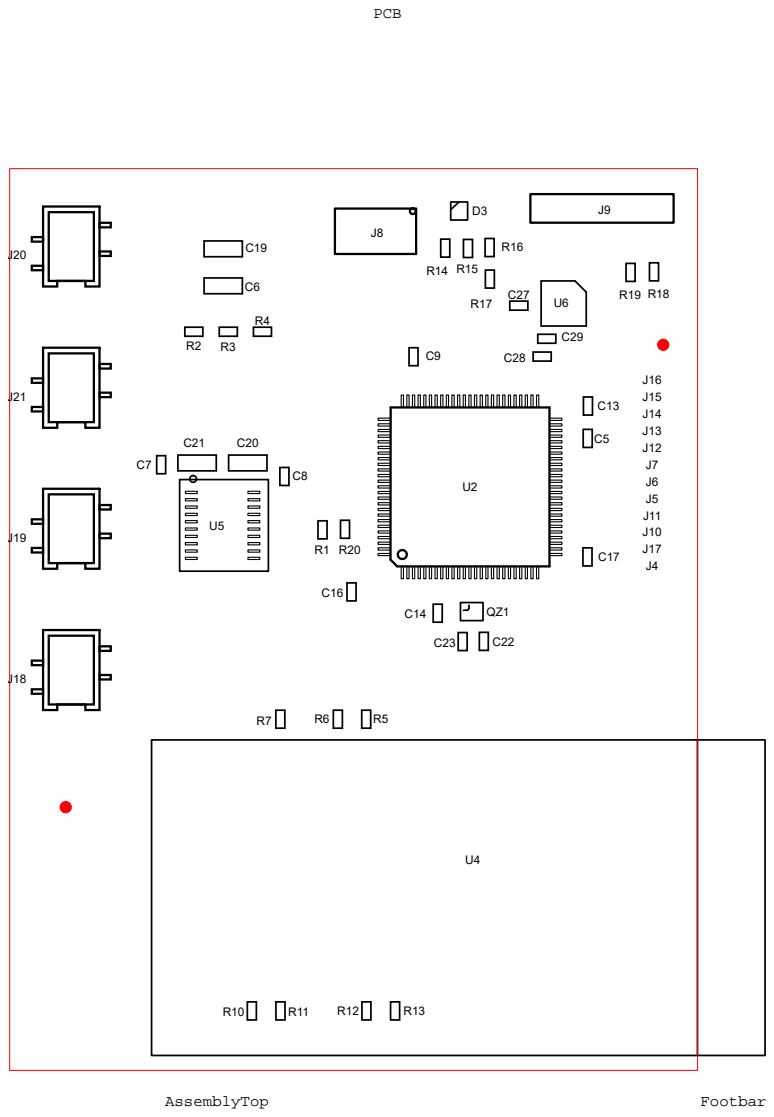
[picture p23: page 1]
