bouLED/bouled/design/main_board/bouled_mainboard/Assembly/PDF/PCB.pdf

## Top layer

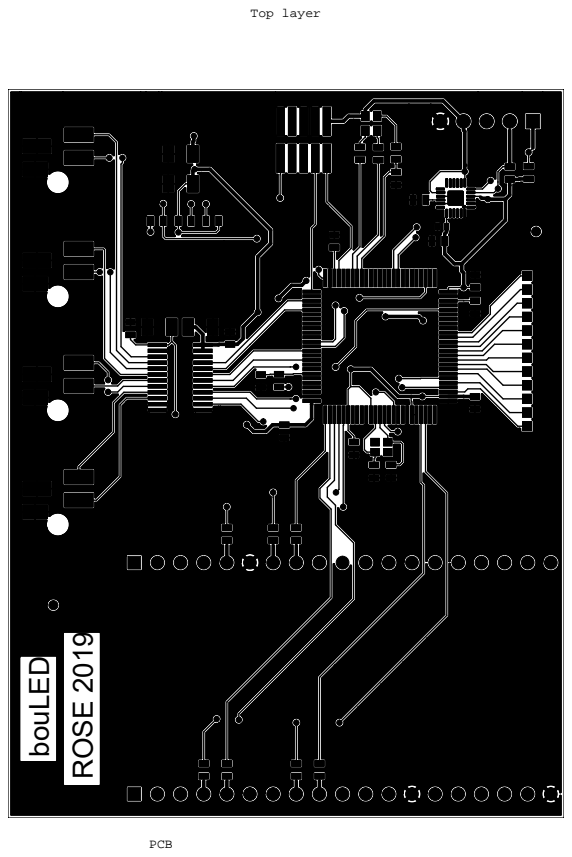
[picture p24: page 1]
PCB; ROSE 2019; bouLED

## Bottom Layer

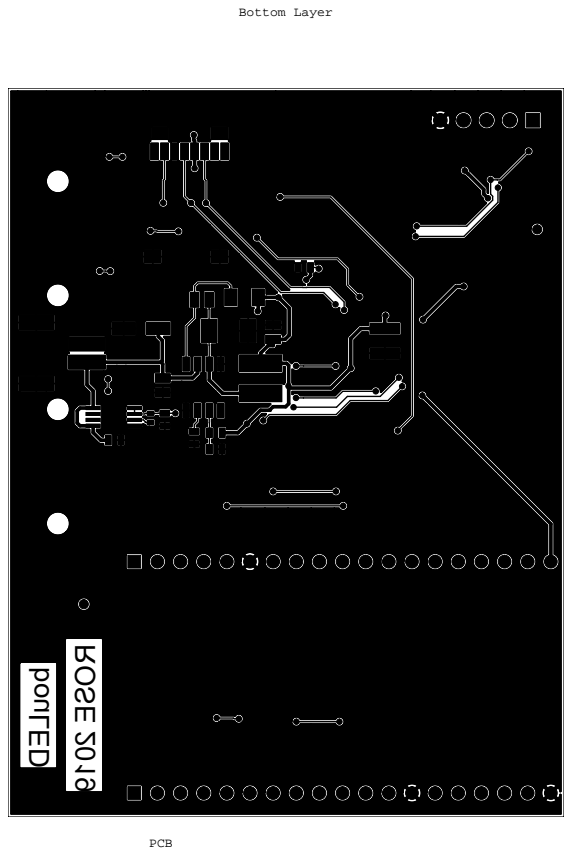
[picture p25: page 2]
PCB; ROSE 2019; bouLED

## Assembly Top

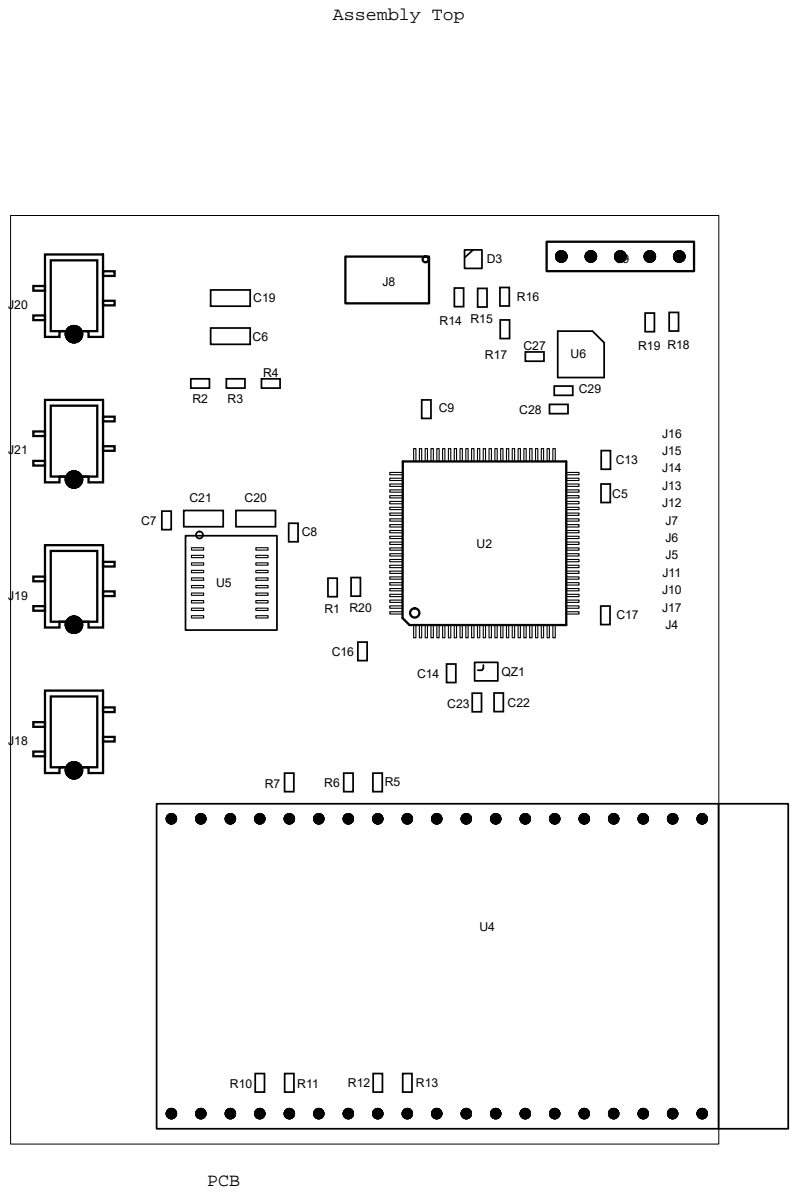
[picture p26: page 3]

## Assembly Bottom

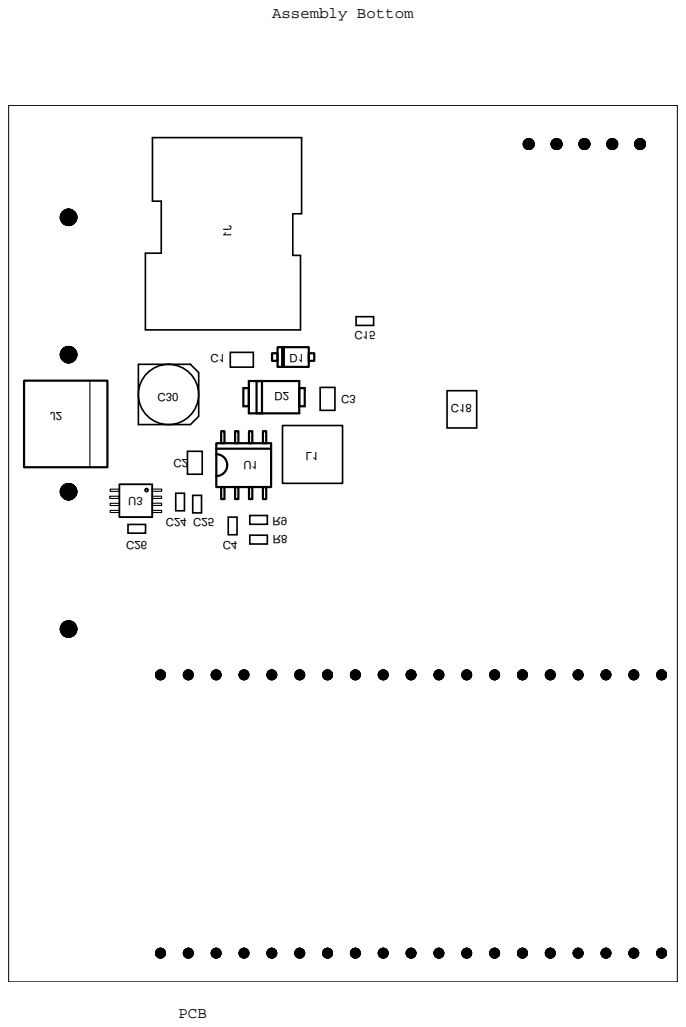
[picture p27: page 4]

## Silk Screen Top

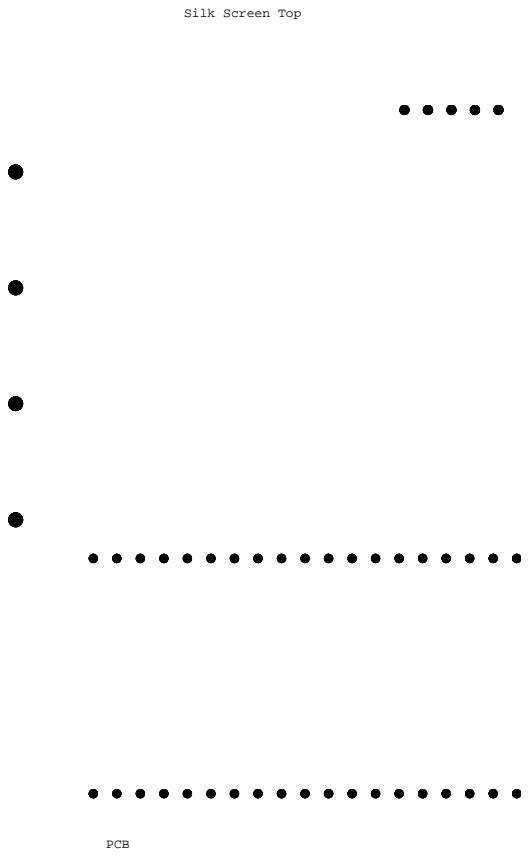
[picture p28: page 5]
PCB

## Silk Screen Bottom

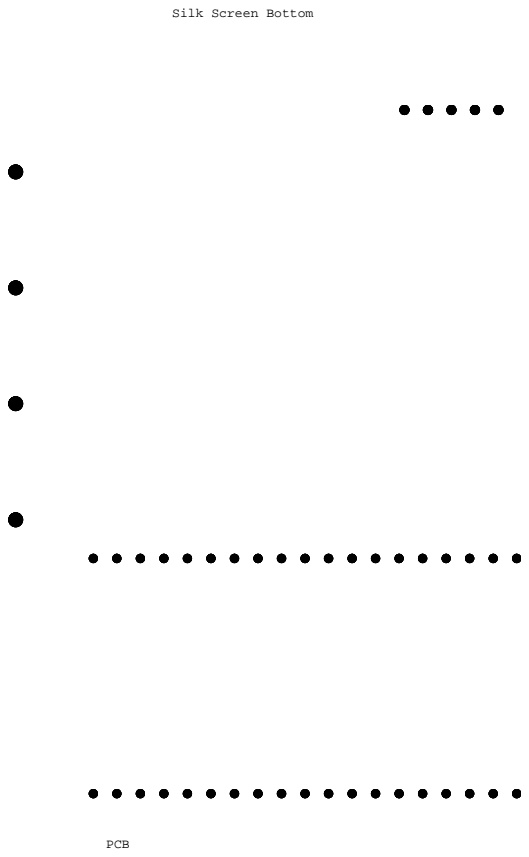
[picture p29: page 6]
PCB
