bouLED/bouled/design/main_board/bouled_mainboard/Assembly/PDF/PCB_Human.pdf

### PCB

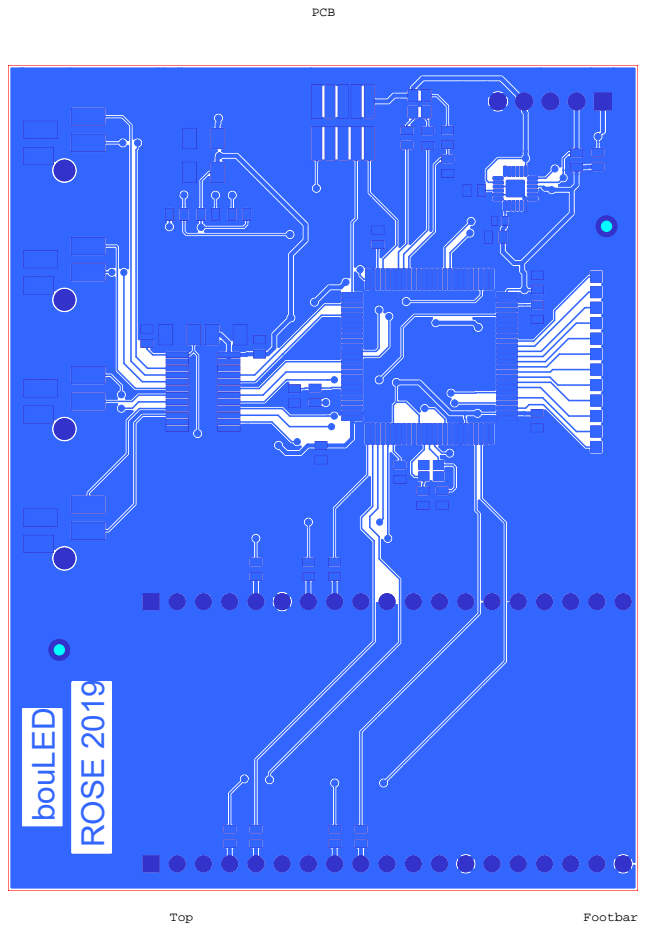
[picture p30: page 1]
Top; Footbar; ROSE 2019; bouLED

### PCB

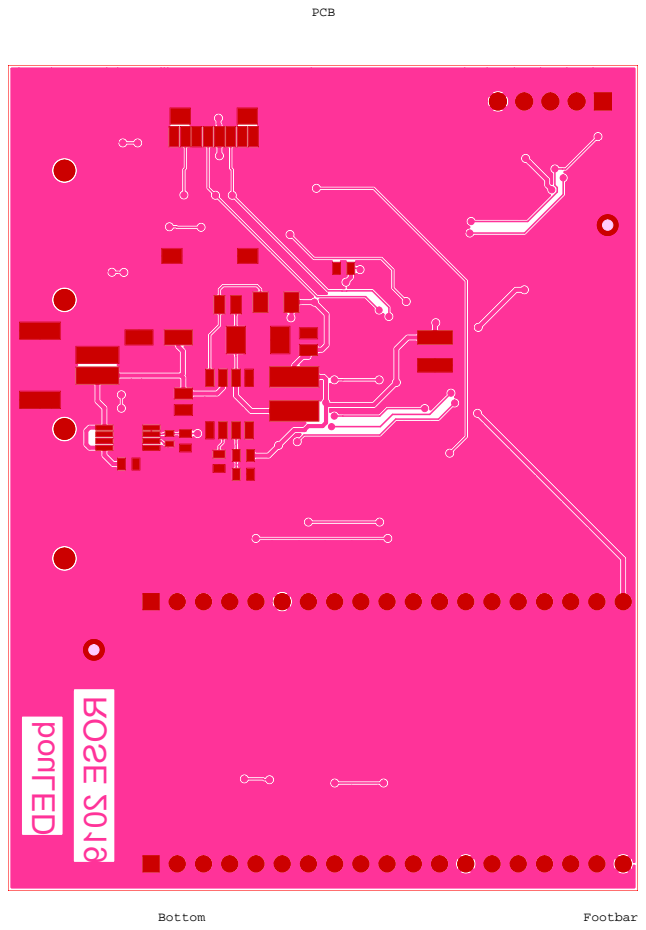
[picture p31: page 2]
Bottom; Footbar; ROSE 2019; bouLED

### PCB

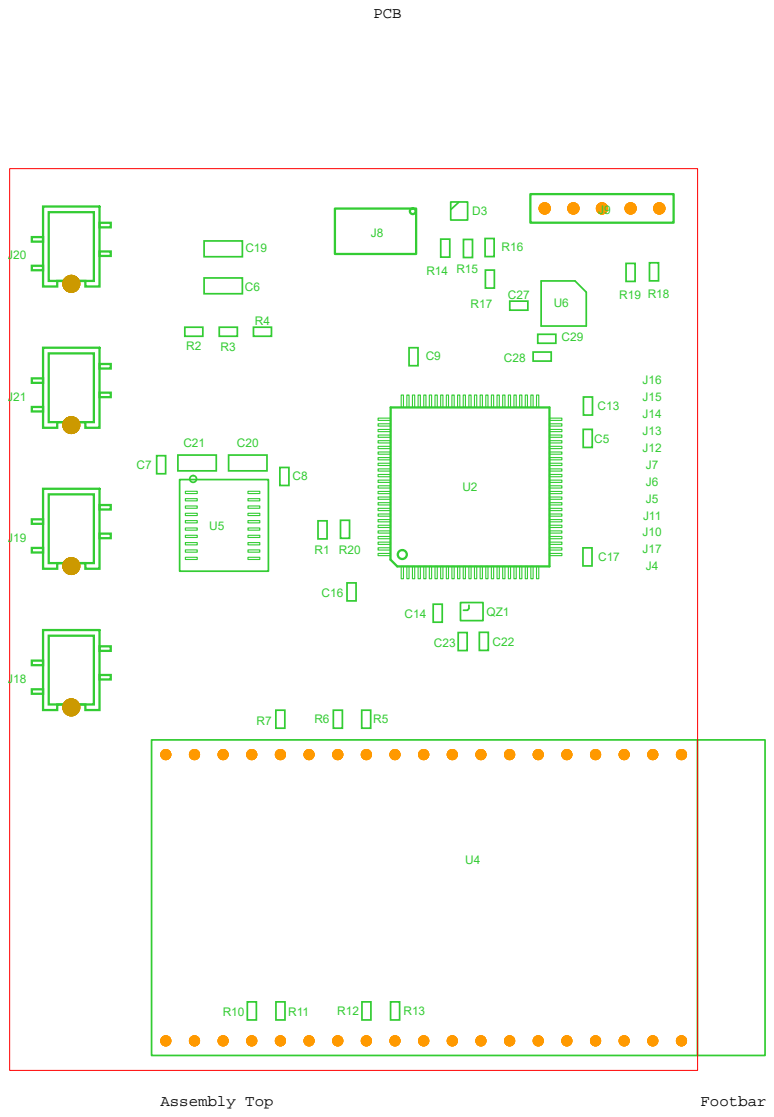
[picture p32: page 3]

### PCB

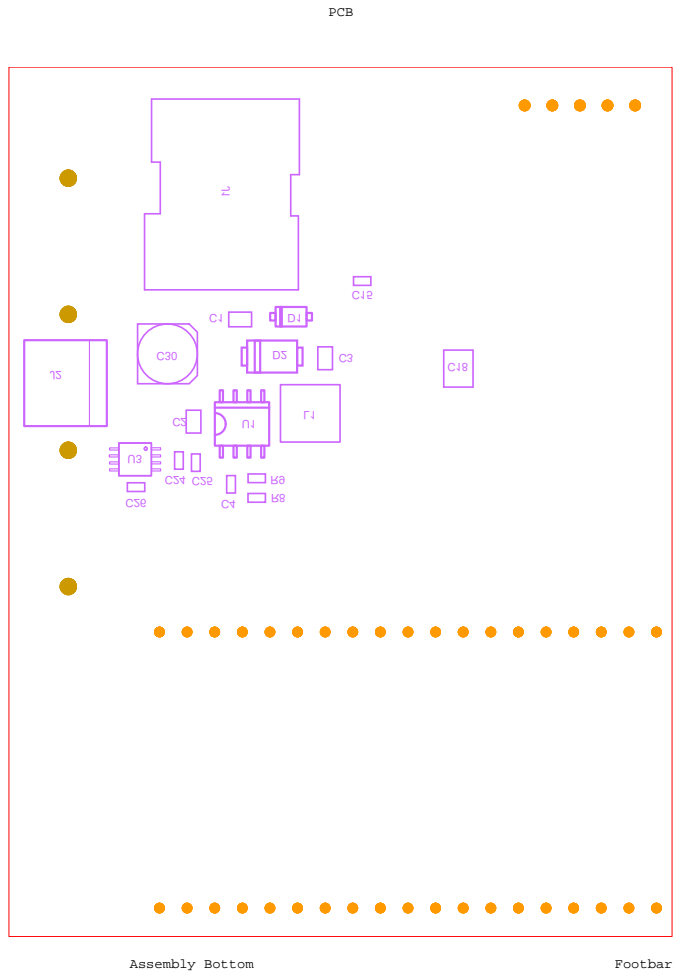
[picture p33: page 4]

### PCB

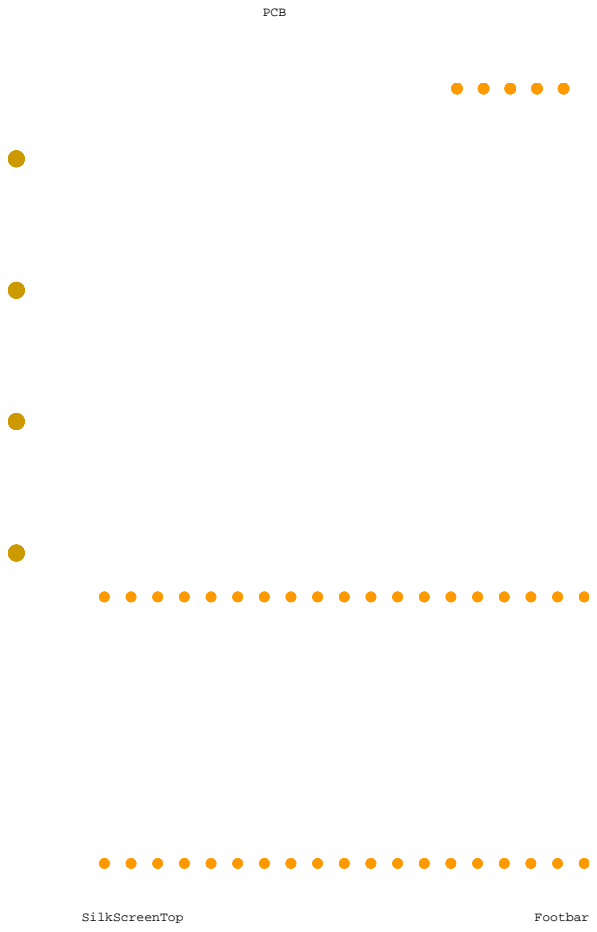
[picture p34: page 5]
SilkScreenTop; Footbar

### PCB

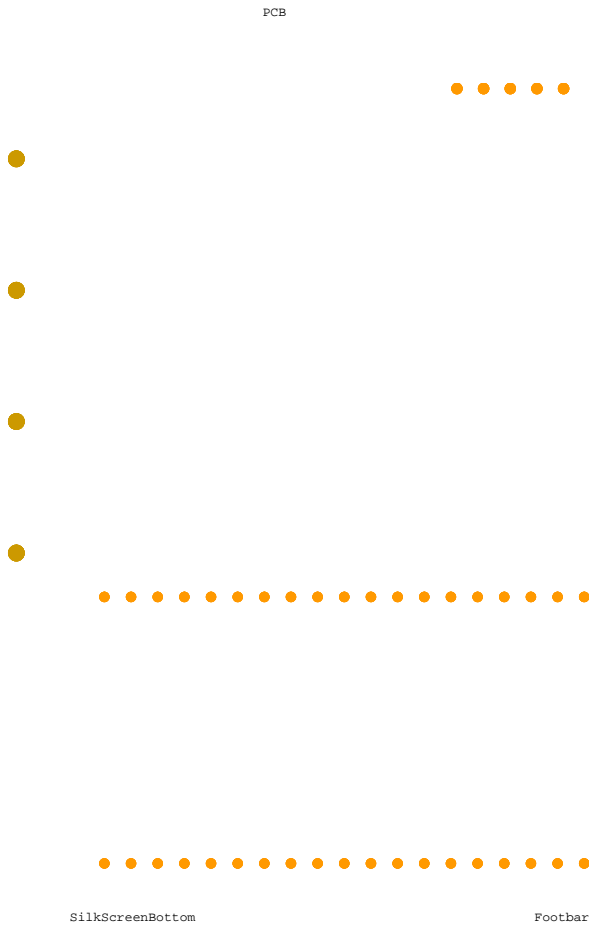
[picture p35: page 6]
SilkScreenBottom; Footbar

### PCB

61mm

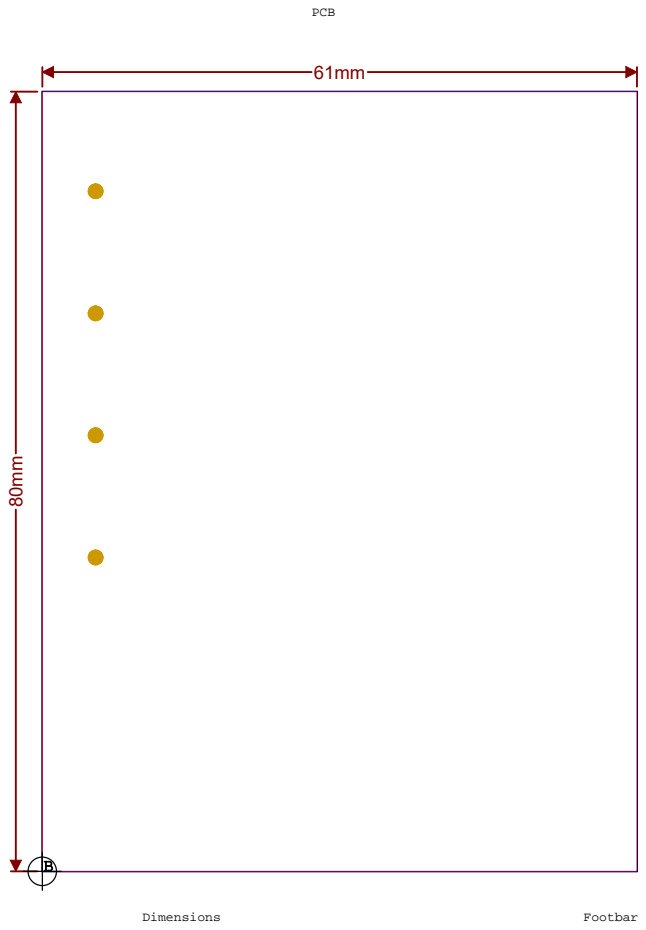
[picture p36: page 7]
Dimensions; Footbar
