bouLED/bouled/design/LED_Panel/design.pdf

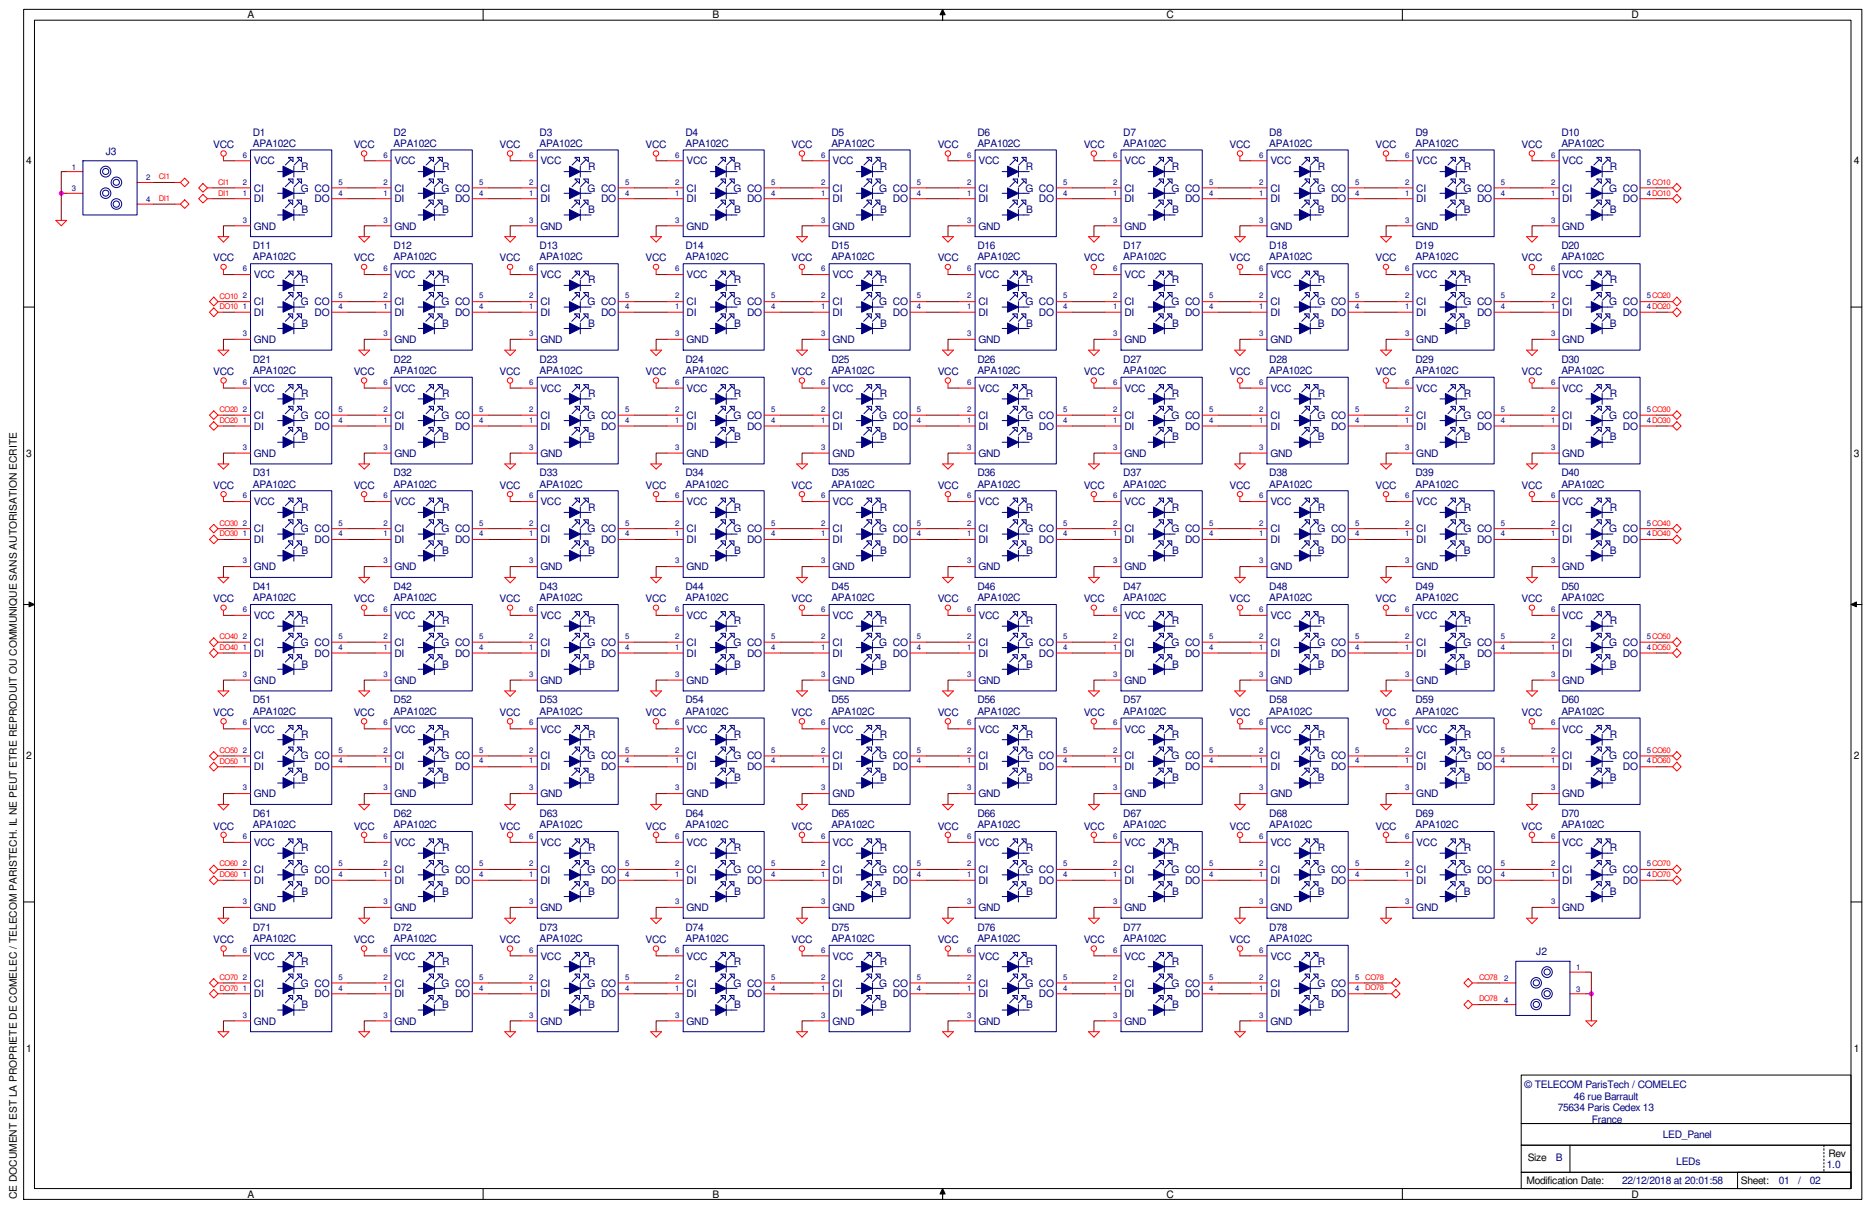
[picture p37: page 1]

CE DOCUMENT EST LA PROPRIETE DE COMELEC / TELECOM PARISTECH. IL NE PEUT ETRE REPRODUIT OU COMMUNIQUE SANS AUTORISATION ECRITE

A | B

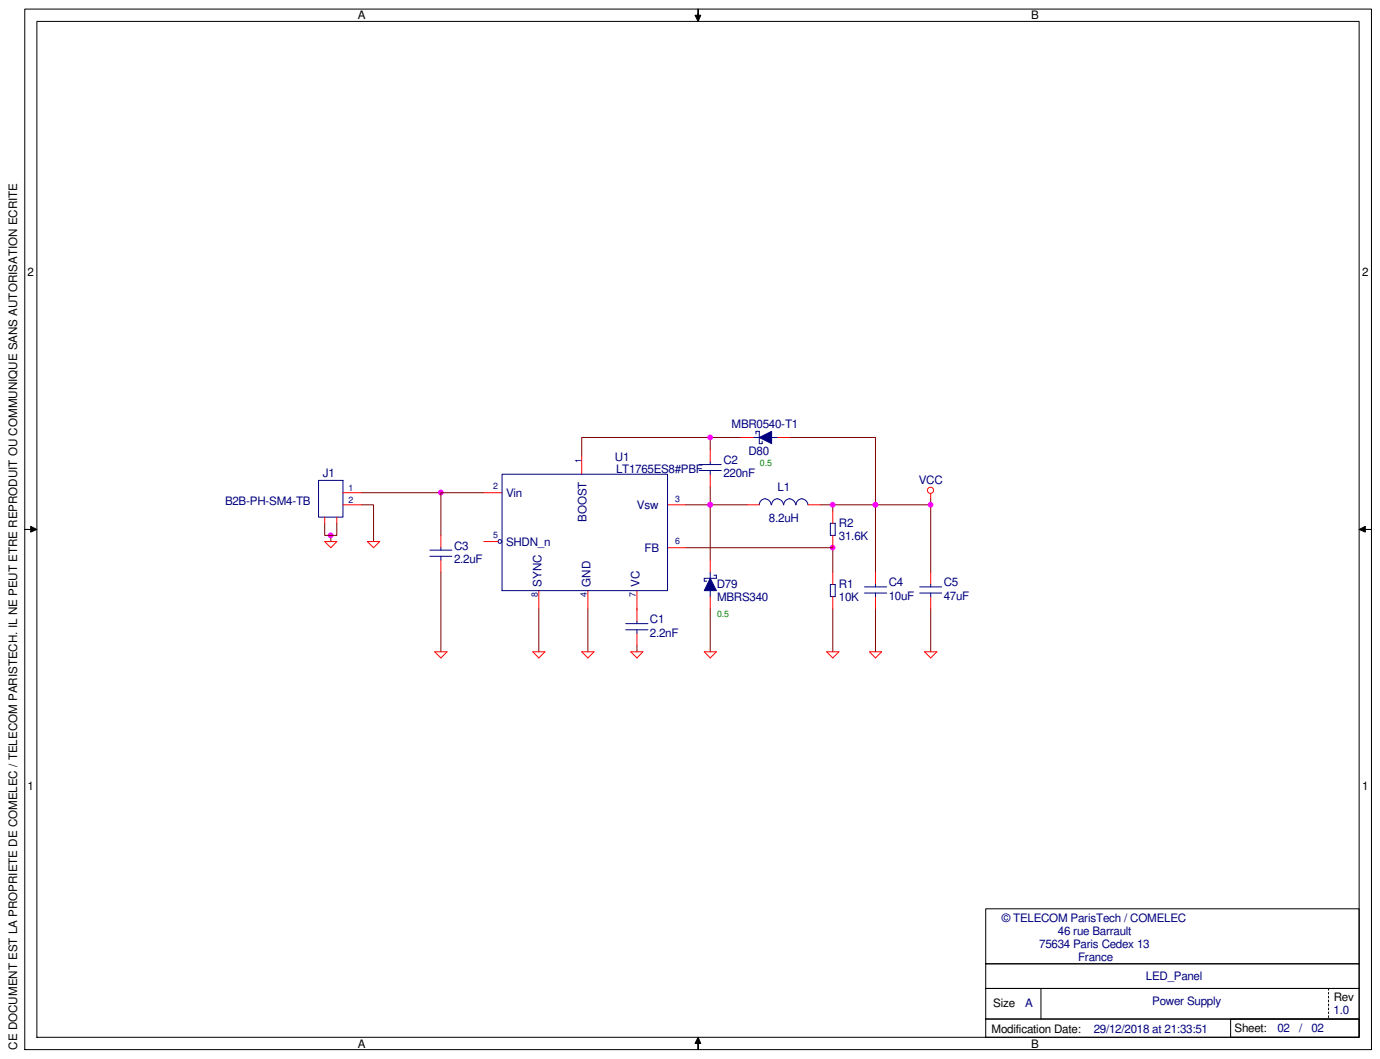
[picture p38: page 2]
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
