bouLED/bouled/design/main_board/bouled_mainboard/Assembly/PDF/Assembly_Bottom.pdf

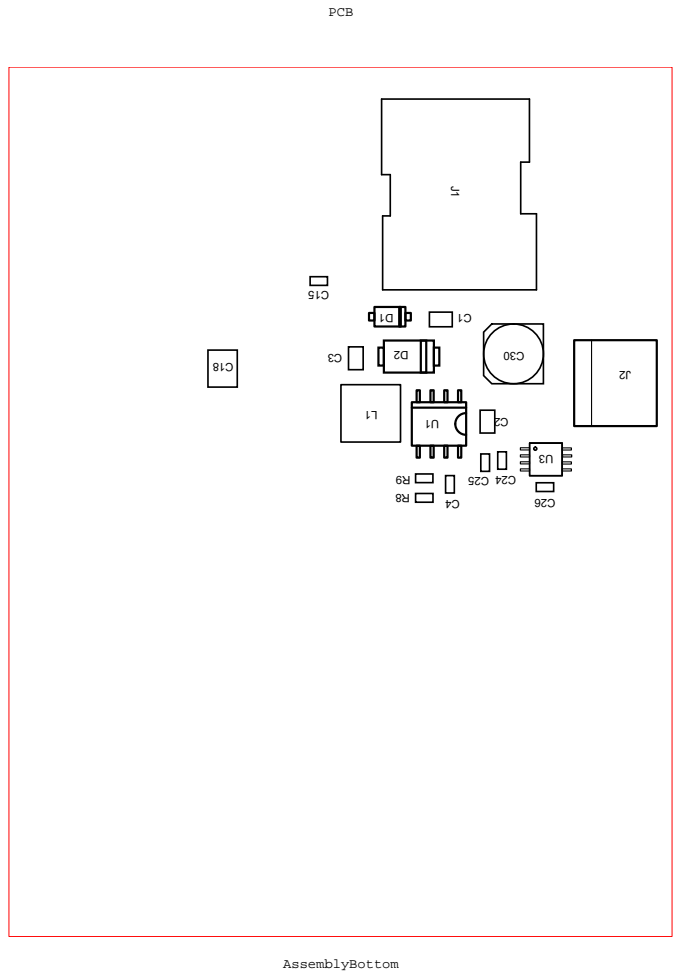
[picture p39: page 1]
