bouLED/bouled/(list of files, drawings)

Other design files:
design/LED_Panel/PCB/Layout/LayoutDB.lyt
design/LED_Panel/PCB/Layout/Revert.lyt
design/LED_Panel/PCB/Output/Gerber/PCB.dsn
design/LED_Panel/PCB/PCB.pcb
design/LED_Panel/PCB/Work/BackupDatabase/LayoutDB.lyt
design/LED_Panel/PCB/Work/BackupDatabase/Revert.lyt
design/LED_Panel/PCB/Work/Layout_Temp/LayoutDB.lyt
design/main_board/bouled_mainboard/PCB/Layout/LayoutDB.lyt
design/main_board/bouled_mainboard/PCB/Layout/Revert.lyt
design/main_board/bouled_mainboard/PCB/Output/Gerber/PCB.dsn
design/main_board/bouled_mainboard/PCB/PCB.pcb
design/main_board/bouled_mainboard/PCB/Work/BackupDatabase/LayoutDB.lyt
design/main_board/bouled_mainboard/PCB/Work/BackupDatabase/Revert.lyt
design/main_board/bouled_mainboard/PCB/Work/Layout_Temp/LayoutDB.lyt
