bouLED/bouled/firmwares/mainboard/src/mx/mainboard.ioc

Mcu.UserName=STM32H743VITx
PA5.Signal=SPI1_SCK
PA7.Signal=SPI1_MOSI
PB10.Signal=SPI2_SCK
PB14.Signal=SDMMC2_D0
PB5.Signal=SPI6_MOSI
PC1.Signal=SPI2_MOSI
PC10.Signal=SPI3_SCK
PC12.Signal=SPI3_MOSI
PD12.Signal=I2C4_SCL
PD13.Signal=I2C4_SDA
PD6.Signal=SDMMC2_CK
PD7.Signal=SDMMC2_CMD
PE2.Signal=SPI4_SCK
PE4.Signal=SPI4_NSS
PE6.Signal=SPI4_MOSI
